everycook/EveryCook-PCB-layouts/README.md

EveryCook-PCB-layouts
=====================

All PCB layouts for the latest EveryCook. They work together, therefore they have a common repository
