everycook/EveryCook-PCB-layouts/EveryCook_boards_spec_V2.ods

Sheet: Logic_board
Line/Signal | In/Out | Voltage (V) | Current (A) | Routed to | Routed to | Remarks | RasPI | Atmel | Schema_Check
Power 12V | Input | 12 | 1 | Voltage Regulator | ProxSwPWR+ | Feeding power | 0 | 0 | x
Power 5V | Input | 5 | 3 | Voltage Regulator | ProxSwPWR+ | Feeding power | 0 | 0 | x
Power GND | Input | 10-30 | 3 | Voltage Regulator | ProxSwPWR- | Feeding power | 0 | 0 | x
ProxSwPWR+ | Output | 10-30 | 0.1 |  |  | Motor proximity switch | 0 | 0 | x
ProxSwPWR- | Output | 10-30 | 0.1 |  |  | Motor proximity switch | 0 | 0 | x
ProxSwSig | Input | 0 | 0.01 | Atmel |  | Motor proximity switch | 0 | 1 | x
MotorPWM | Output | 3.3 | 0.01 | Atmel |  |  | 0 | 1 | x
CoverClosedSW+ | Input | 5 | 0.01 | RasPi GPIO |  | Safety | 1 | 0 | x
coverClosedSW- | Output | 0 | 0.01 | GND |  |  | 0 | 0 | x
CoverLockedSW+ | Input | 5 | 0.01 | RasPi GPIO |  | Safety | 1 | 0 | x
CoverLockedSW- | Output | 0 | 0.01 | GND |  |  | 0 | 0 | x
PusherLockedSW+ | Input | 5 | 0.01 | RasPi GPIO |  | Safety | 1 | 0 | x
PusherLockedSW- | Output | 0 | 0.01 | GND |  |  | 0 | 0 | x
Button1+ | Input | 5 | 0.01 | RasPi GPIO |  | WIFI/DaemonRST, Shutdown | 1 | 0 | x
Button1- | Output | 0 | 0.01 | GND |  |  | 0 | 0 | x
Button2+ | Input | 5 | 0.01 | RasPi GPIO |  | Read step/ON/OFF | 1 | 0 | x
Button2- | Output | 0 | 0.01 | GND |  |  | 0 | 0 | x
Button3+ | Input | 5 | 0.01 | RasPi GPIO |  | Next step | 1 | 0 | x
Button3- | Output | 0 | 0.01 | GND |  |  | 0 | 0 | x
Loadcell1P+ | Output | 5 | 0.01 | precise 5V |  |  | 0 | 0
Loadcell1Sig+ | Input | 0.1 | 0.01 | AD7794 |  |  | 0 | 0
Loadcell1Sig- | Input | 0.1 | 0.01 | AD7794 |  |  | 0 | 0
Loadcell1P- | Output | 0 | 0.01 | GND |  |  | 0 | 0
Loadcell2P+ | Output | 5 | 0.01 | precise 5V |  |  | 0 | 0
Loadcell2Sig+ | Input | 0.1 | 0.01 | AD7794 |  |  | 0 | 0
Loadcell2Sig- | Input | 0.1 | 0.01 | AD7794 |  |  | 0 | 0
Loadcell2P- | Output | 0 | 0.01 | GND |  |  | 0 | 0
Loadcell3P+ | Output | 5 | 0.01 | precise 5V |  |  | 0 | 0
Loadcell3Sig+ | Input | 0.1 | 0.01 | AD7794 |  |  | 0 | 0
Loadcell3Sig- | Input | 0.1 | 0.01 | AD7794 |  |  | 0 | 0
Loadcell3P- | Output | 0 | 0.01 | GND |  |  | 0 | 0
Loadcell4P+ | Output | 5 | 0.01 | precise 5V |  |  | 0 | 0
Loadcell4Sig+ | Input | 0.1 | 0.01 | AD7794 |  |  | 0 | 0
Loadcell4Sig- | Input | 0.1 | 0.01 | AD7794 |  |  | 0 | 0
Loadcell4P- | Output | 0 | 0.01 | GND |  |  | 0 | 0
PressuresensorP+ | Output | 5 | 0.01 | precise 5V |  |  | 0 | 0
PressuresensorSig+ | Input | 0.1 | 0.01 | AD7794 |  |  | 0 | 0
PressuresensorSig- | Input | 0.1 | 0.01 | AD7794 |  |  | 0 | 0
PressuresensorP- | Output | 0 | 0.01 | GND |  |  | 0 | 0
PT100+ | Input | 5 | 0.01 | AD7794 |  |  | 0 | 0
PT100- | Output | 0 | 0.01 | GND |  |  | 0 | 0
IH_ON | Output | 3.3 | 0.01 | RasPi GPIO |  |  | 1 | 0 | x
IH OFF | Output | 3.3 | 0.01 | RasPi GPIO |  |  | 1 | 0 | x
IH_POWER | Output | 3.3 | 0.01 | RasPi GPIO |  |  | 1 | 0 | x
IH_FEEDBACK | Input | 3.3 | 0.01 | RasPi GPIO |  |  | 1 | 0 | x
Powerbutton_LED+ | Output | 3.3 | 0.01 | RasPi GPIO |  |  | 1 | 0
Powerbutton_LED- | Output | 0 | 0.01 | GND |  |  | 0 | 0
Speaker+ | Output |  |  | AudioAmp |  |  | 0 | 0
Speaker- | Output | 0 |  | AudioAmp |  |  | 0 | 0
AudioIn+ | Input |  |  | AudioAmp |  |  | 0 | 0
AudioIn- | Output | 0 |  | AudioAmp |  |  | 0 | 0
Rpi_TX | Output | 3.3 | 0.01 | RasPi GPIO |  |  | 1 | 0 | x
Rpi_RX | Input | 3.3 | 0.01 | RasPi GPIO |  |  | 1 | 0 | x
Atmel_RST_OUT | Output | 3.3 | 0.01 | RasPi GPIO |  |  | 1 | 0 | x
Atmel_Rx | Input | 3.3 | 0.01 | Atmel |  |  | 0 | 1 | x
Atmel_Tx | Output | 3.3 | 0.01 | Atmel |  |  | 0 | 1 | x
Atmel_RST_IN | Input | 3.3 | 0.01 | Atmel |  |  | 0 | 1 | x
SPI_CLK | Output | 3.3 | 0.01 | RasPi GPIO |  |  | 1 | 0 | x
SPI_MISO | Input | 3.3 | 0.01 | RasPi GPIO |  |  | 1 | 0 | x
SPI_MOSI | Output | 3.3 | 0.01 | RasPi GPIO |  |  | 1 | 0 | x
Display 1 | Output | 3.3 | 0.01 | Atmel |  |  | 0 | 1 | x
Display 2 | Output | 3.3 | 0.01 | Atmel |  |  | 0 | 1 | x
Display 3 | Output | 3.3 | 0.01 | Atmel |  |  | 0 | 1 | x
Display 4 | Output | 3.3 | 0.01 | Atmel |  |  | 0 | 1 | x
Display 5 | Output | 3.3 | 0.01 | Atmel |  |  | 0 | 1 | x
Display 6 | Output | 3.3 | 0.01 | Atmel |  |  | 0 | 1 | x
Display 7 | Output | 3.3 | 0.01 | Atmel |  |  | 0 | 1 | x
Display 8 | Output | 3.3 | 0.01 | Atmel |  |  | 0 | 1 | x
Display 9 | Output | 3.3 | 0.01 | Atmel |  |  | 0 | 1 | x
Display 10 | Output | 3.3 | 0.01 | Atmel |  |  | 0 | 1 | x
Display 11 | Output | 3.3 | 0.01 | Atmel |  |  | 0 | 1 | x
Display 12 | Output | 3.3 | 0.01 | Atmel |  |  | 0 | 1 | x
RasPi Reset | Output | 3.3 | 0.01 | Atmel |  |  | 0 | 1 | x
FanPWM | Output | 3.3 | 0.01 | Atmel |  |  | 0 | 1 | x
IGBT_Temp | Input | 3.3 | 0.01 | Atmel |  |  | 0 | 1 | x
HiPower_ON | Output | 3.3 | 0.01 | Atmel |  |  | 0 | 1 | x
 |  |  |  |  |  | Sum | 17 | 21
 |  |  |  |  |  | Reserves | 1 | 0
Raspi GPIOs | 18 | Total | Arduino IO's | 21 | Inkl. RST
Reserve | 0 |  | Reserve | 0
Available | 18 |  | Available | 21

Sheet: Power_board
Line/Signal | In/Out | Voltage (V) | Current (A) | AC/DC | Routed to | Routed to | Remarks
PWR_GND | Input | 0 | 0 | DC | Housing via mounting holes | Connector for other GNDs | General Shielding for EMI and safety
PWR_N_on | Input | 0 | 16 | AC | Rectifier 1A | Rectifier 16A | For 10-30V IH logic and signal board power
PWR_L_on | Input | 230 | 16 | AC | Rectifier 1A | PWR_L_OUT | For 10-30V IH logic and signal board power
PWR_L_OUT | Output | 230 | 16 | AC | Connector to switch |  | To emergency shutdown/Power Switch
PWR_L_sw | Input | 230 | 16 | AC | Rectifier 16A |  | From emergency shutdown/Power Switch
IH_ON | Input | 5 | 0.01 | DC | Optocoupler |  | From signal board, enables heater
IH_POWER | Input | 5 | 0.01 | DC | Optocoupler |  | From signal board, sets heating power in 25% steps
IH_FEEDBACK | Output | 0 | 0.01 | DC | Optocoupler |  | To signal board, tells heating power
IH_COIL+ | Output | 1200 | 50 | AC | IH Circuit |  | TBD
IH_COIL- | Output | 1200 | 50 | AC | iH Circuit |  | TBD
Motor+ | Output | 325 | 2 | DC | DC BUS - |  | Motor GND
Motor- | Output | 325 | 2 | DC | IGBT |  | Motor PWM
DC_OUT | Output | 10-30 | 3 | DC | Voltage Converter |  | Voltage TBD for Logic Board
DC_OUT | Output | 10-30 | 3 | DC | Voltage Converter |  | Voltage TBD for Logic Board
Motor PWM | Input | 5 | 0.01 | DC | IGBT |  | PWM Signal from Logic board
PowerButton1+ | Input | 230 | 0.1 | AC | PowerOnCircuit
Powerbutton1- | Input | 0 | 0.1 | AC | PowerOnCircuit
PowerButton2+ | Input | 230 | 0.1 | AC | PowerOnCircuit
Powerbutton2- | Input | 0 | 0.1 | AC | PowerOnCircuit

Sheet: notes
OK Spule zu UK Topf | 17 | mm
