everycook/EveryCook-PCB-layouts/Datasheets/FNA41060B2-schema.jpeg

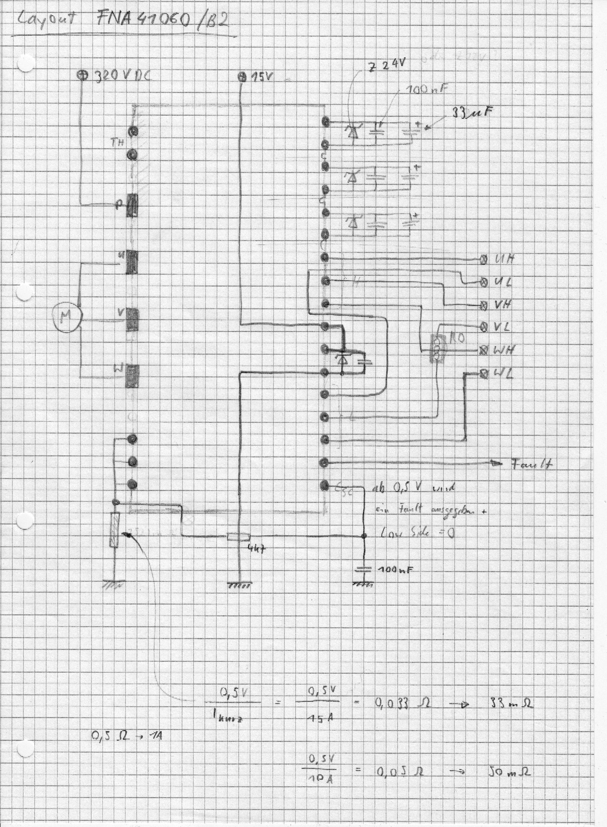
Datasheets/FNA41060B2-schema.jpeg
