everycook/EveryCook-PCB-layouts/Datasheets/MC3PHAC-schema.jpeg

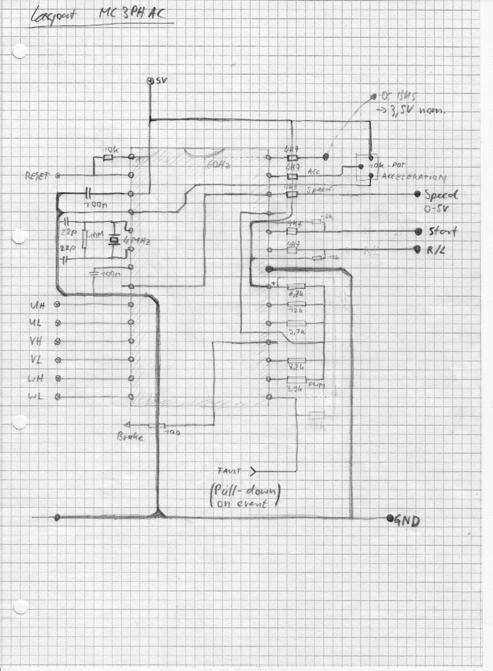
Datasheets/MC3PHAC-schema.jpeg
