everycook/EveryCook-PCB-layouts/Examples/arduino-duemilanove-sch.gif

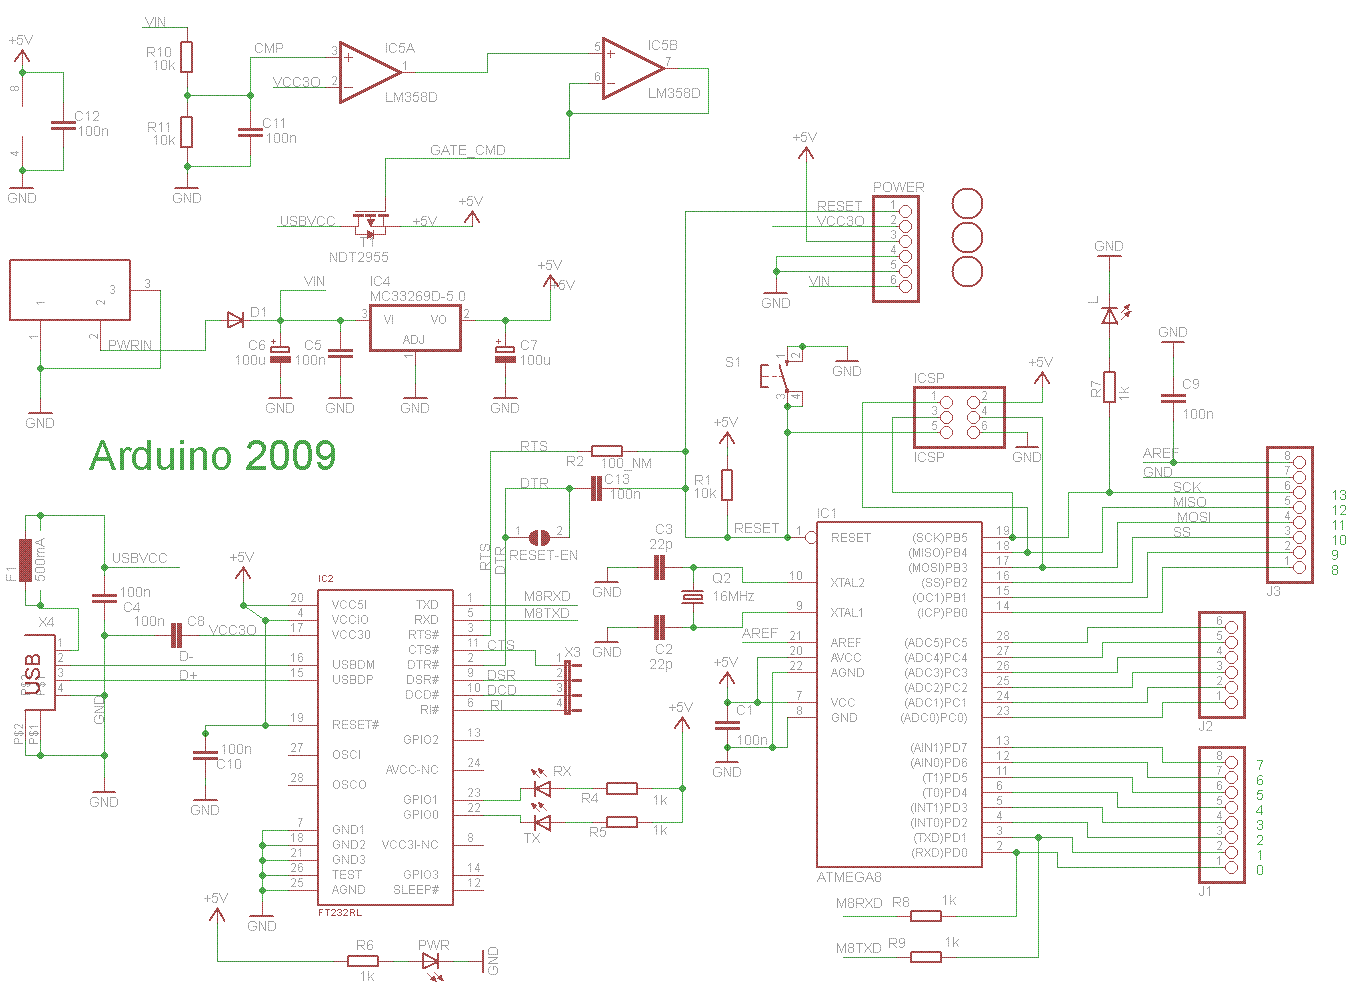
Examples/arduino-duemilanove-sch.gif
