everycook/EveryCook-PCB-layouts/Examples/Sanguino.png

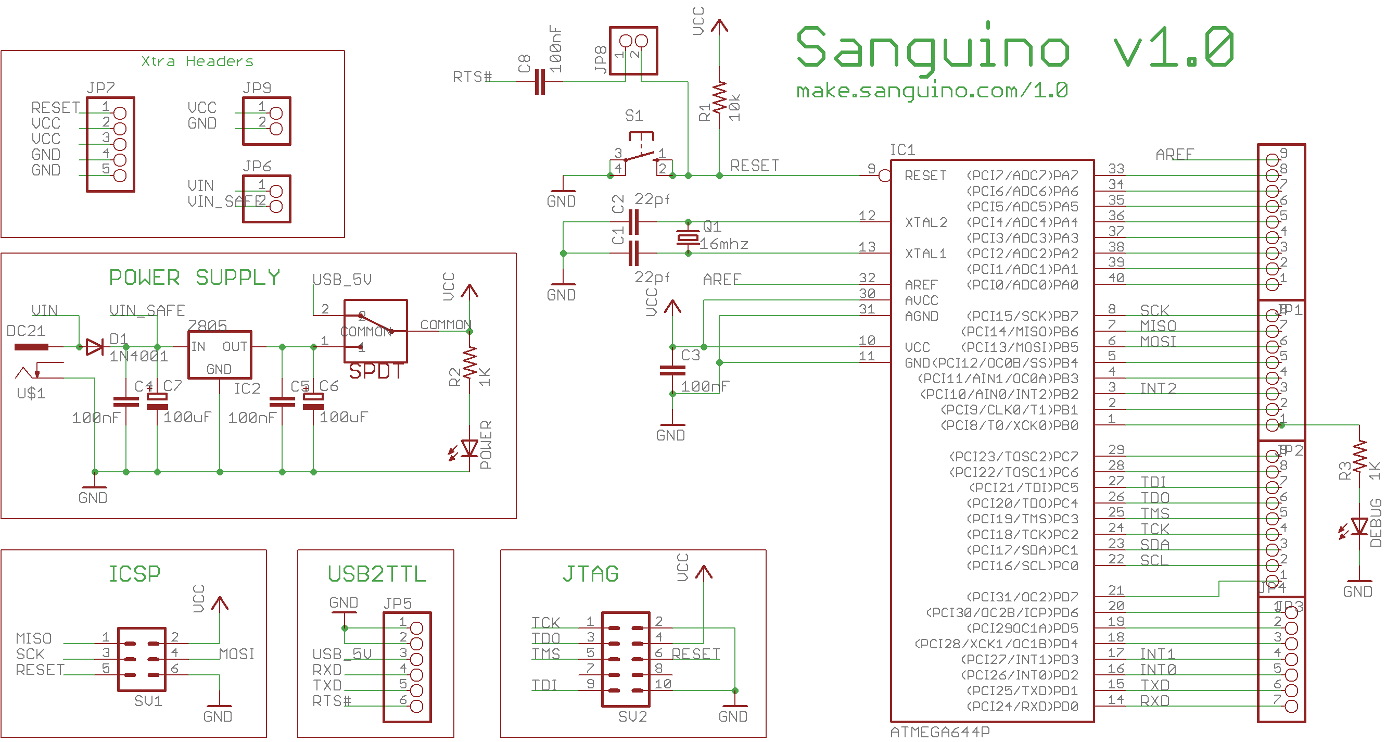
Examples/Sanguino.png
