everycook/EveryCook-PCB-layouts/LoadCellAmp/LoadCellAmp.png

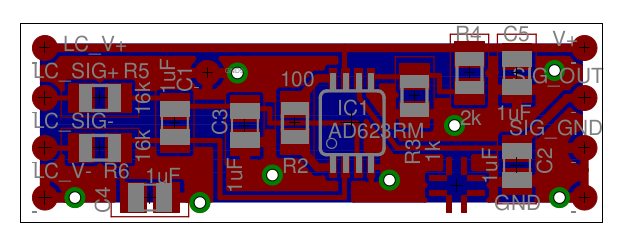
LoadCellAmp/LoadCellAmp.png
