everycook/EveryCook-PCB-layouts/Display/Display_EveryCook.xls

Part | Value | Device | Package | Description | Color
JP1 |  | PINHD-2X6 | 2X06 | PIN HEADER
LED1 |  | LEDKA-3528ASYC | KA-3528ASYC | LED | blue
LED2 |  | LEDKA-3528ASYC | KA-3528ASYC | LED | blue
LED3 |  | LEDKA-3528ASYC | KA-3528ASYC | LED | blue
LED4 |  | LEDKA-3528ASYC | KA-3528ASYC | LED | blue
LED5 |  | LEDKA-3528ASYC | KA-3528ASYC | LED | blue
LED6 |  | LEDKA-3528ASYC | KA-3528ASYC | LED | blue
LED7 |  | LEDKA-3528ASYC | KA-3528ASYC | LED | blue
LED8 |  | LEDKA-3528ASYC | KA-3528ASYC | LED | blue
LED9 |  | LEDKA-3528ASYC | KA-3528ASYC | LED | blue
LED10 |  | LEDKA-3528ASYC | KA-3528ASYC | LED | blue
LED11 |  | LEDKA-3528ASYC | KA-3528ASYC | LED | blue
LED12 |  | LEDKA-3528ASYC | KA-3528ASYC | LED | blue
LED13 |  | LEDKA-3528ASYC | KA-3528ASYC | LED | blue
LED14 |  | LEDKA-3528ASYC | KA-3528ASYC | LED | blue
LED15 |  | LEDKA-3528ASYC | KA-3528ASYC | LED | blue
LED16 |  | LEDKA-3528ASYC | KA-3528ASYC | LED | blue
LED17 |  | LEDKA-3528ASYC | KA-3528ASYC | LED | blue
LED18 |  | LEDKA-3528ASYC | KA-3528ASYC | LED | blue
LED19 |  | LEDKA-3528ASYC | KA-3528ASYC | LED | blue
LED20 |  | LEDKA-3528ASYC | KA-3528ASYC | LED | blue
LED21 |  | LEDKA-3528ASYC | KA-3528ASYC | LED | blue
LED22 |  | LEDKA-3528ASYC | KA-3528ASYC | LED | blue
LED23 |  | LEDKA-3528ASYC | KA-3528ASYC | LED | blue
LED24 |  | LEDKA-3528ASYC | KA-3528ASYC | LED | blue
LED25 |  | LEDKA-3528ASYC | KA-3528ASYC | LED | blue
LED26 |  | LEDKA-3528ASYC | KA-3528ASYC | LED | blue
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
LED107 |  | LEDKA-3528ASYC | KA-3528ASYC | LED | blue
LED108 |  | LEDKA-3528ASYC | KA-3528ASYC | LED | blue
LED109 |  | LEDKA-3528ASYC | KA-3528ASYC | LED | blue
LED110 |  | LEDKA-3528ASYC | KA-3528ASYC | LED | blue
LED111 |  | LEDKA-3528ASYC | KA-3528ASYC | LED | blue
LED112 |  | LEDKA-3528ASYC | KA-3528ASYC | LED | blue
LED113 |  | LEDKA-3528ASYC | KA-3528ASYC | LED | blue
LED114 |  | LEDKA-3528ASYC | KA-3528ASYC | LED | blue
LED115 |  | LEDKA-3528ASYC | KA-3528ASYC | LED | blue
LED116 |  | LEDKA-3528ASYC | KA-3528ASYC | LED | blue
LED117 |  | LEDKA-3528ASYC | KA-3528ASYC | LED | blue
LED118 |  | LEDKA-3528ASYC | KA-3528ASYC | LED | blue
LED119 |  | LEDKA-3528ASYC | KA-3528ASYC | LED | blue
LED120 |  | LEDKA-3528ASYC | KA-3528ASYC | LED | blue
LED121 |  | LEDKA-3528ASYC | KA-3528ASYC | LED | blue
LED122 |  | LEDKA-3528ASYC | KA-3528ASYC | LED | blue
LED123 |  | LEDKA-3528ASYC | KA-3528ASYC | LED | blue
LED124 |  | LEDKA-3528ASYC | KA-3528ASYC | LED | blue
LED125 |  | LEDKA-3528ASYC | KA-3528ASYC | LED | blue
LED126 |  | LEDKA-3528ASYC | KA-3528ASYC | LED | blue
