everycook/EveryCook-PCB-layouts/IH/EveryCookPWR (Alexis Wiasmitinows in Konflikt stehende Kopie 2014-01-17).dxf

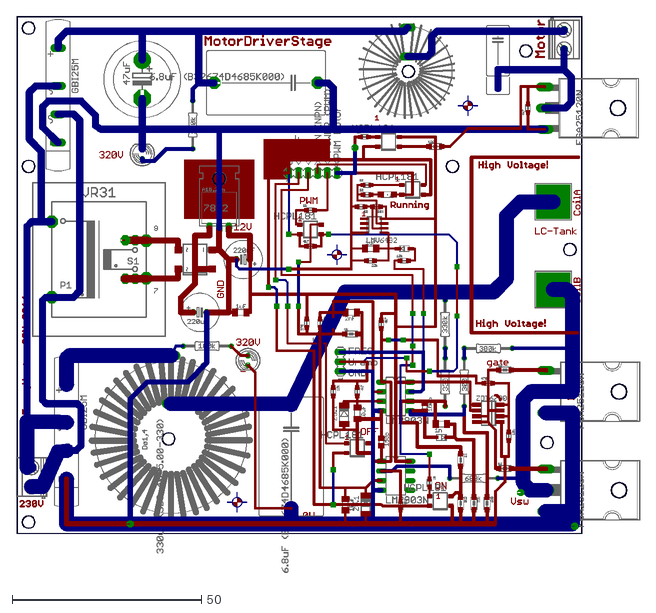
[picture p6: CAD file, 2014-01-18]
IH/EveryCookPWR (Alexis Wiasmitinows in Konflikt stehende Kopie 2014-01-17).dxf
164.9 x 147.0
