everycook/EveryCook-PCB-layouts/LoadCellAmp/LoadCellAmp.dxf

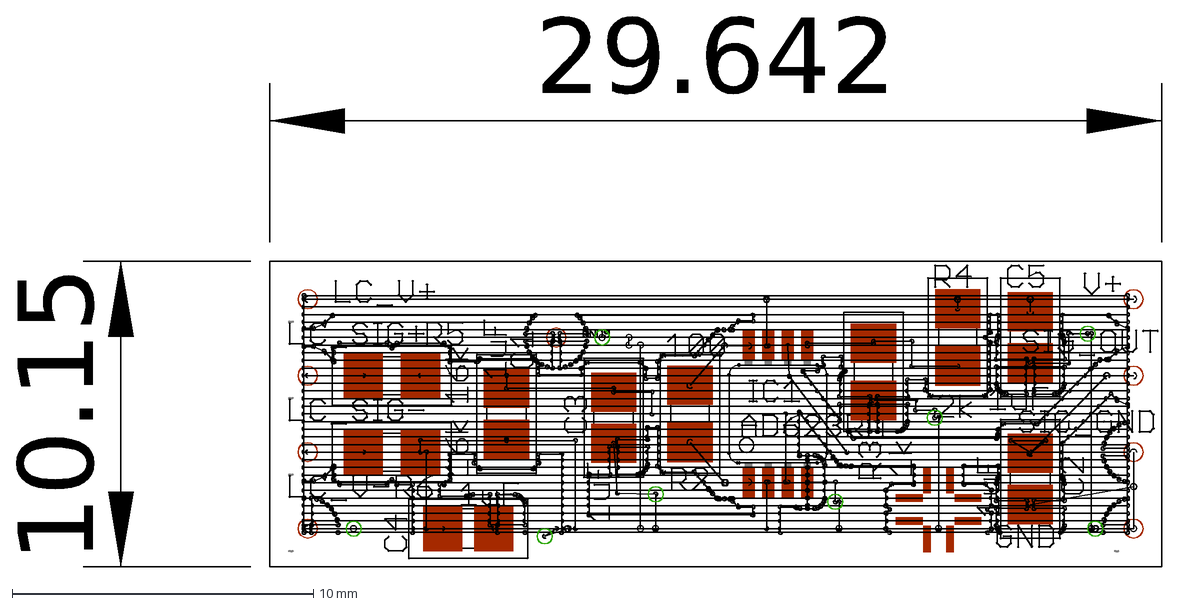
[picture p7: CAD file, 2014-08-21]
LoadCellAmp/LoadCellAmp.dxf
10.15
29.642
