everycook/EveryCook-PCB-layouts/SafetyChain/SafetyChain.dxf

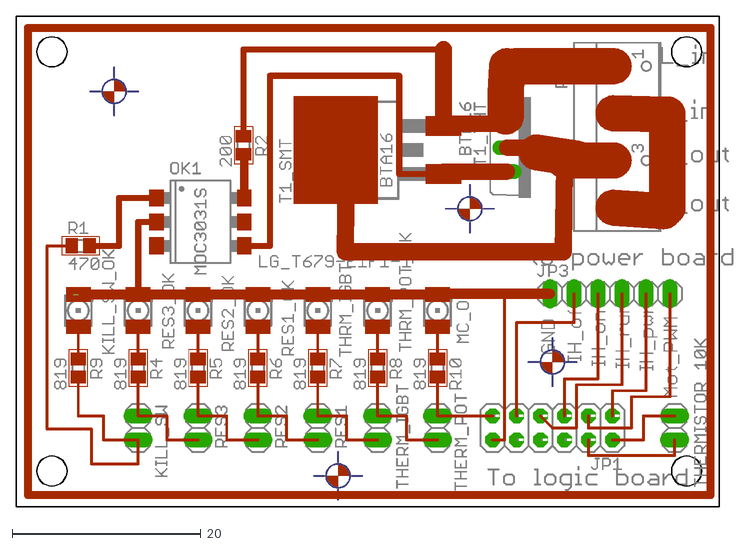
[picture p8: CAD file, 2014-02-05]
SafetyChain/SafetyChain.dxf
76.0 x 52.1
