everycook/EveryCook-PCB-layouts/IH/EveryCookPWR.dxf

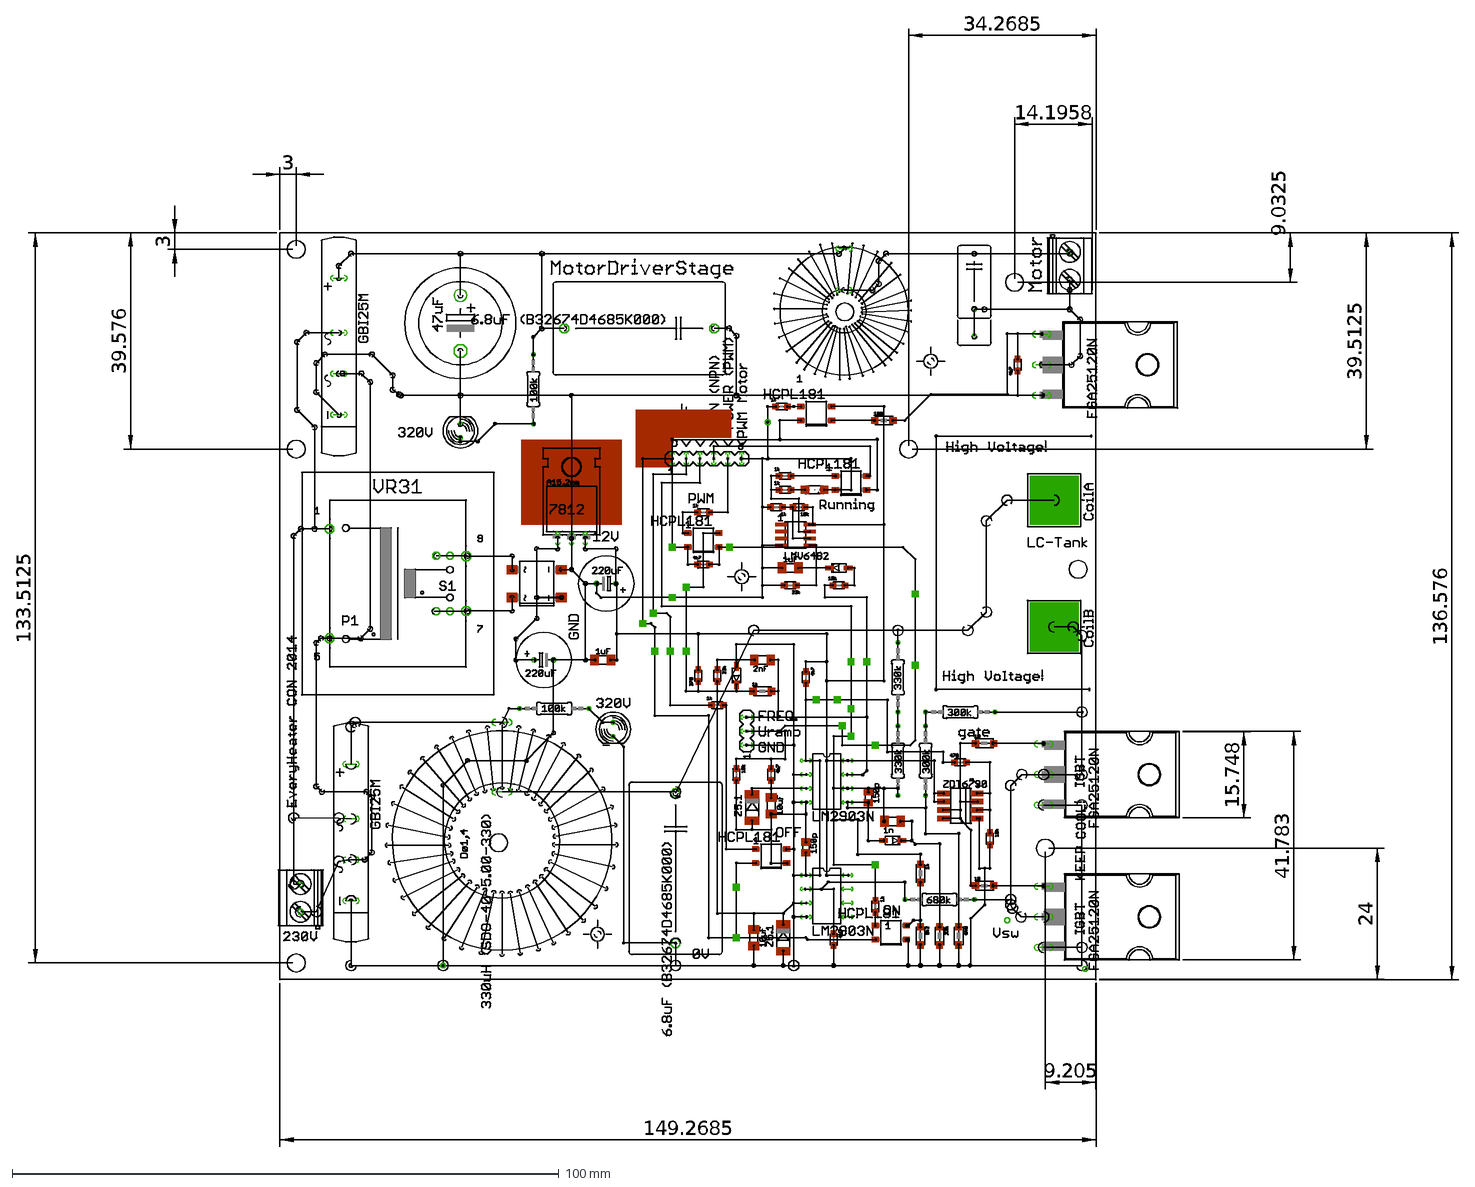
[picture p9: CAD file, 2014-01-18]
IH/EveryCookPWR.dxf
41.783
15.748
149.2685
136.576
3
39.576
133.5125
39.5125
9.0325
24
14.1958
34.2685
9.205
