everycook/EveryCook-PCB-layouts/LoadCellAmp/LoadCellAmp_brd.pdf

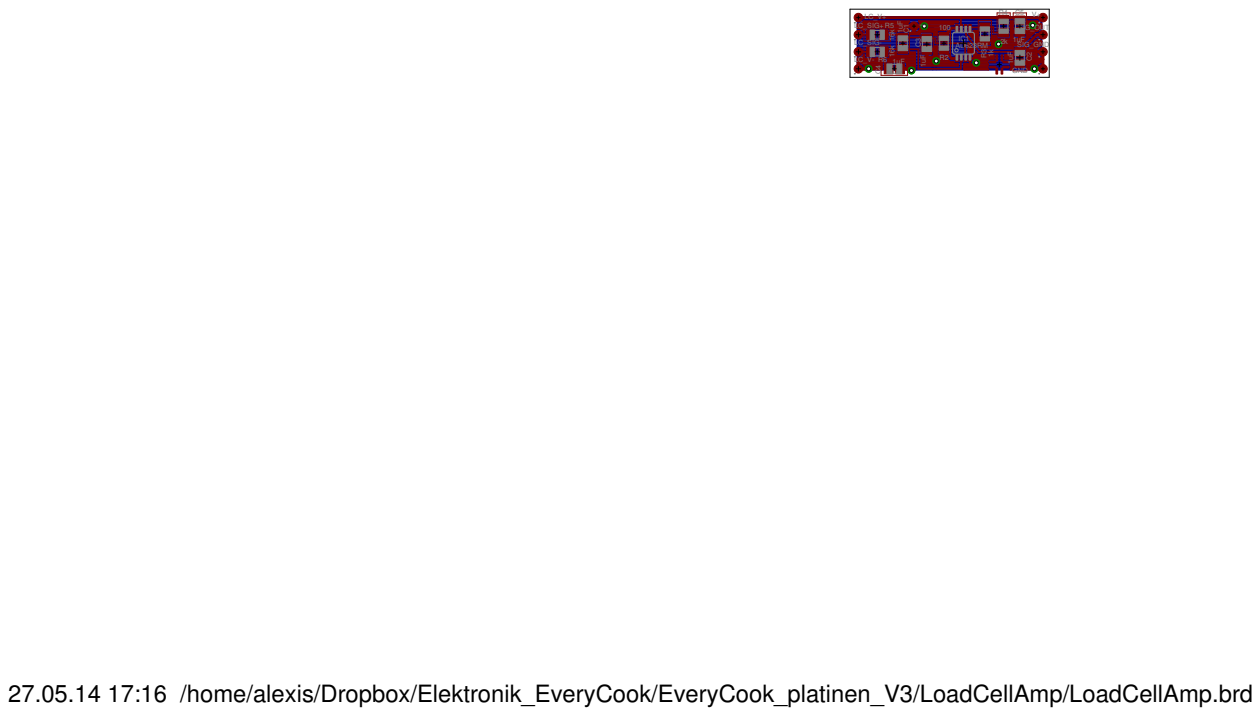
[picture p10: page 1]

LC_SIG+ 100

GND9 | R2 | AD623RM IC1 C1 | 1uF

LC_SIG- LC_V- | | | | SIG_GND

27.05.14 17:16 /home/alexis/Dropbox/Elektronik_EveryCook/EveryCook_platinen_V3/LoadCellAmp/LoadCellAmp.brd
