everycook/EveryCook-PCB-layouts/Mainboard/EveryCook_Mainboard_brd.pdf

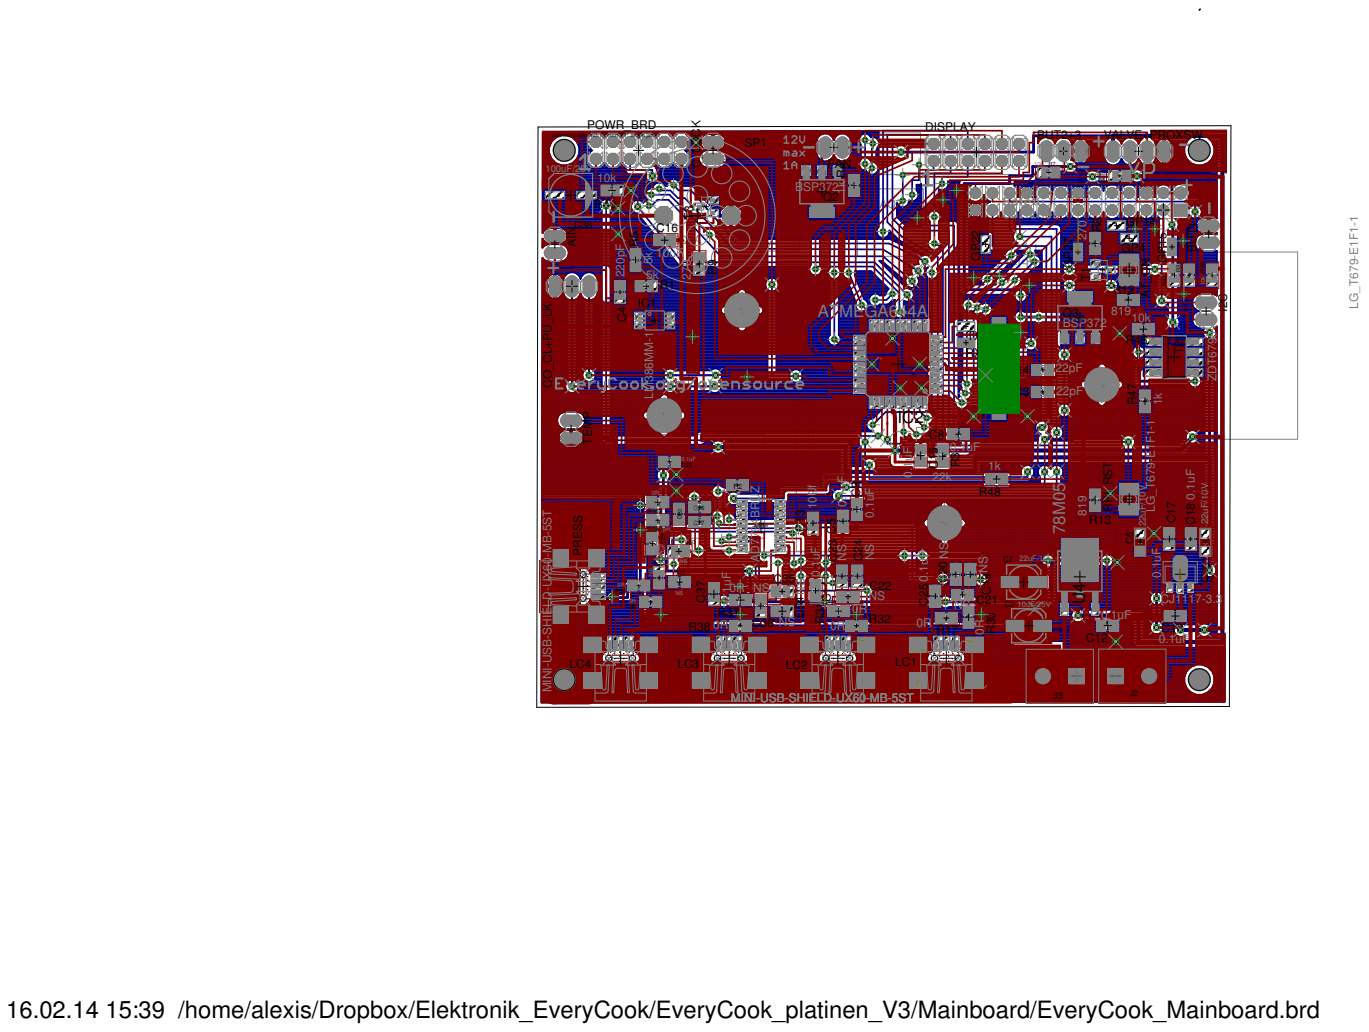
[picture p11: page 1]

connect cable with 3.5mm 90° angle jack

10k | | FAN Q2 R4 | R6 R7

BSP372 1k

BSP372 | | 10k

MINI-USB-SHIELD-UX60-MB-5ST

16.02.14 15:39 /home/alexis/Dropbox/Elektronik_EveryCook/EveryCook_platinen_V3/Mainboard/EveryCook_Mainboard.brd
