everycook/EveryCook-PCB-layouts/Examples/TRIAC-driver.pdf

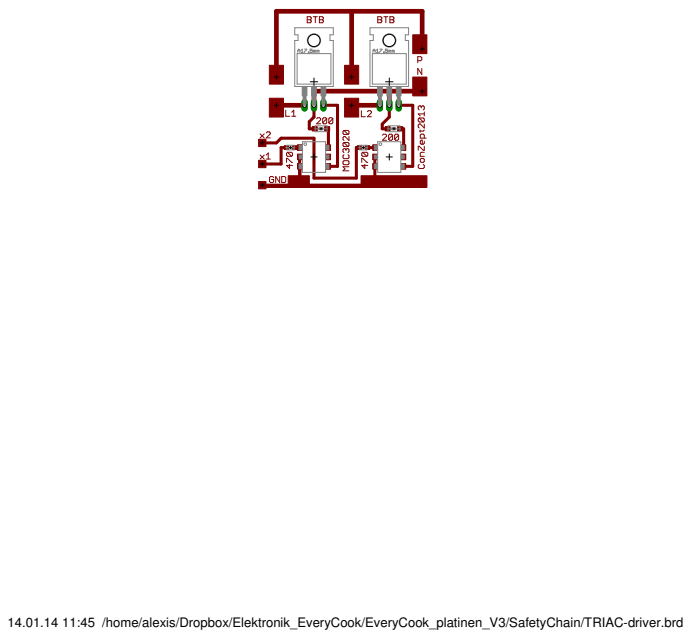
[picture p12: page 1]

14.01.14 11:45 /home/alexis/Dropbox/Elektronik_EveryCook/EveryCook_platinen_V3/SafetyChain/TRIAC-driver.brd
