everycook/EveryCook-PCB-layouts/ADC_LoadCell_Board/ADC_LoadCell_Board_brd.pdf

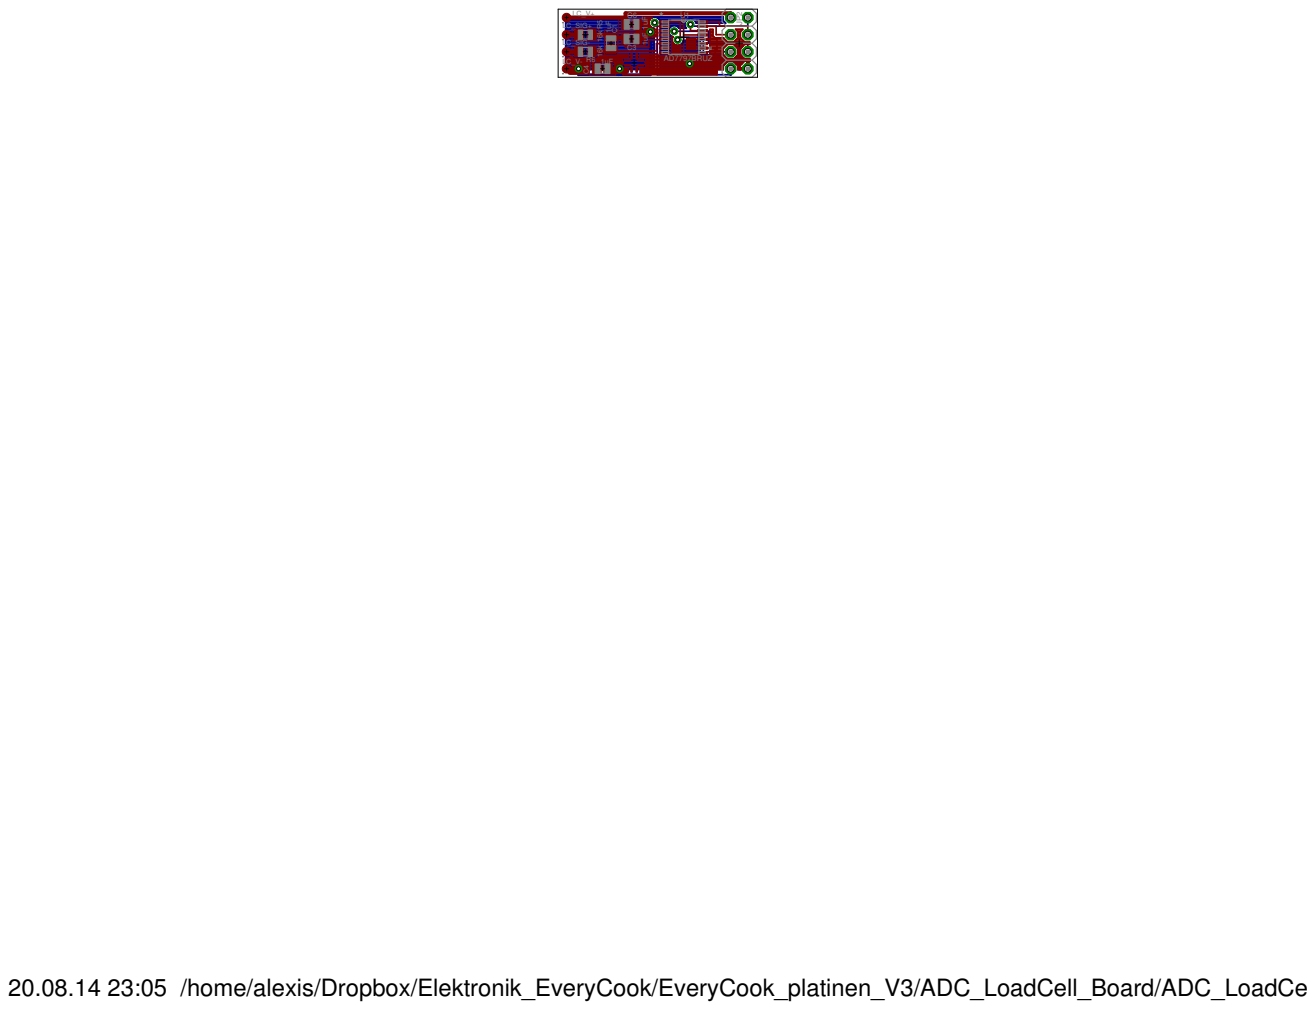
[picture p13: page 1]

20.08.14 23:05 /home/alexis/Dropbox/Elektronik_EveryCook/EveryCook_platinen_V3/ADC_LoadCell_Board/ADC_LoadCell_Board.brd
