everycook/EveryCook-PCB-layouts/ADC_LoadCell_Board/ADC_LoadCell_Board_sch.pdf

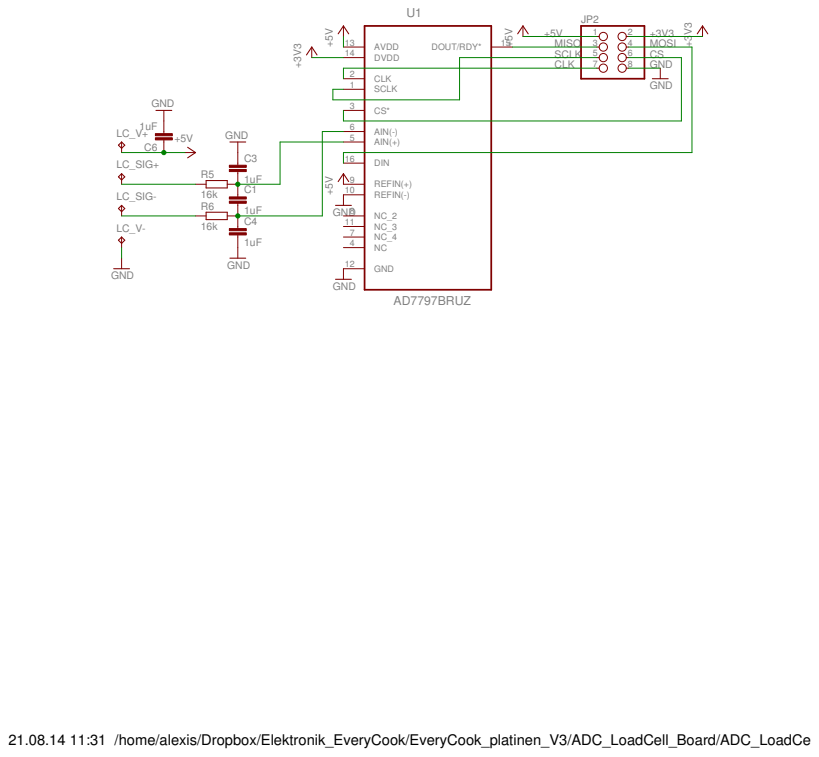
[picture p14: page 1]

21.08.14 11:31 /home/alexis/Dropbox/Elektronik_EveryCook/EveryCook_platinen_V3/ADC_LoadCell_Board/ADC_LoadCell_Board.sch (Sheet: 1/1)
