everycook/EveryCook-PCB-layouts/InductionHeater/InductionHeater.pdf

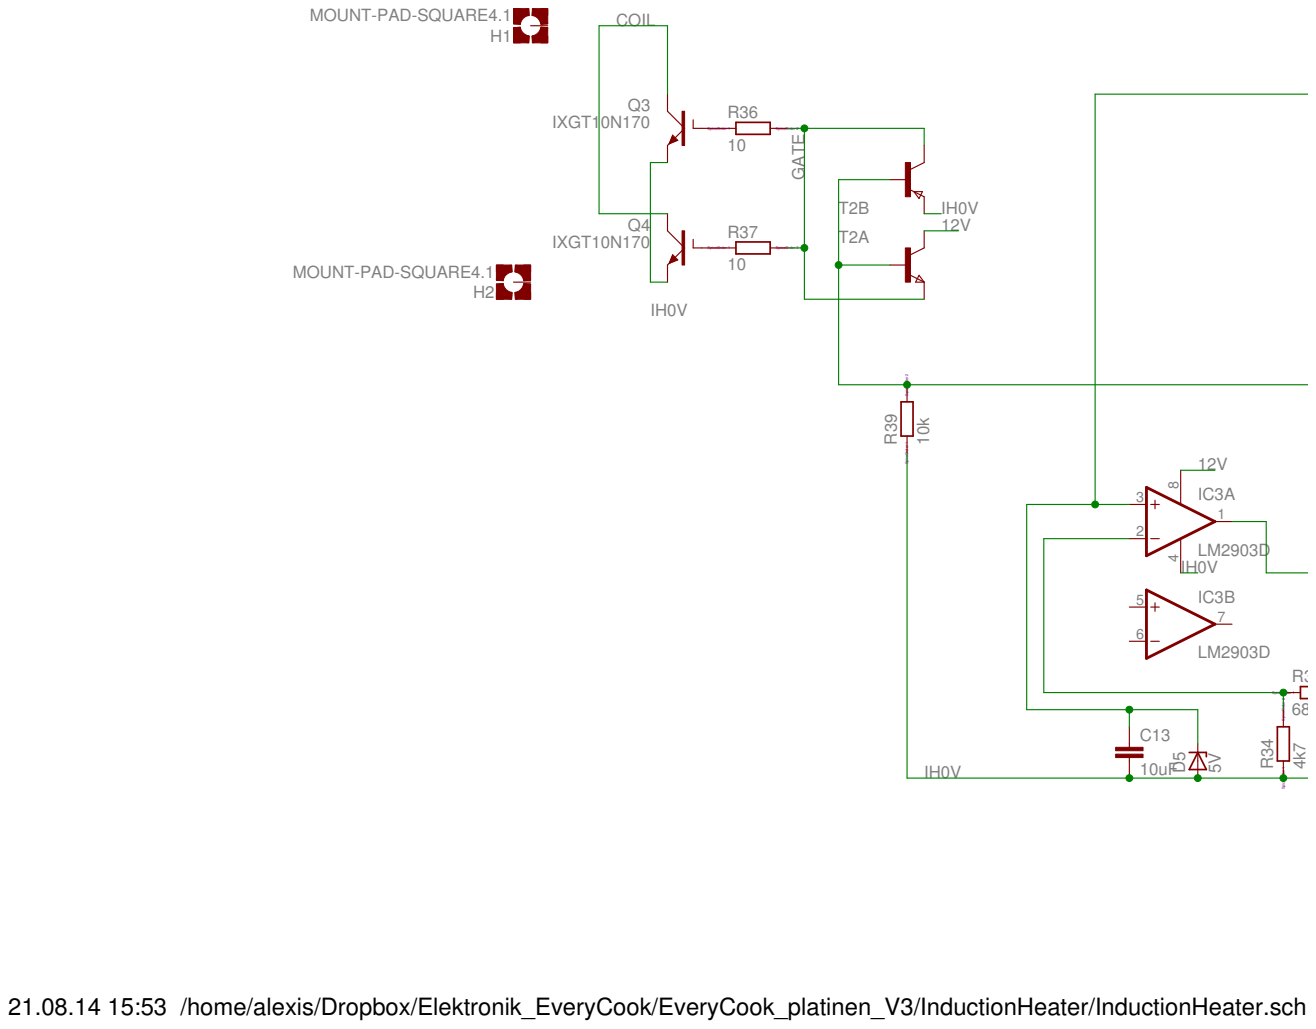
[picture p15: page 1]

21.08.14 15:53 /home/alexis/Dropbox/Elektronik_EveryCook/EveryCook_platinen_V3/InductionHeater/InductionHeater.sch (Sheet: 1/1)

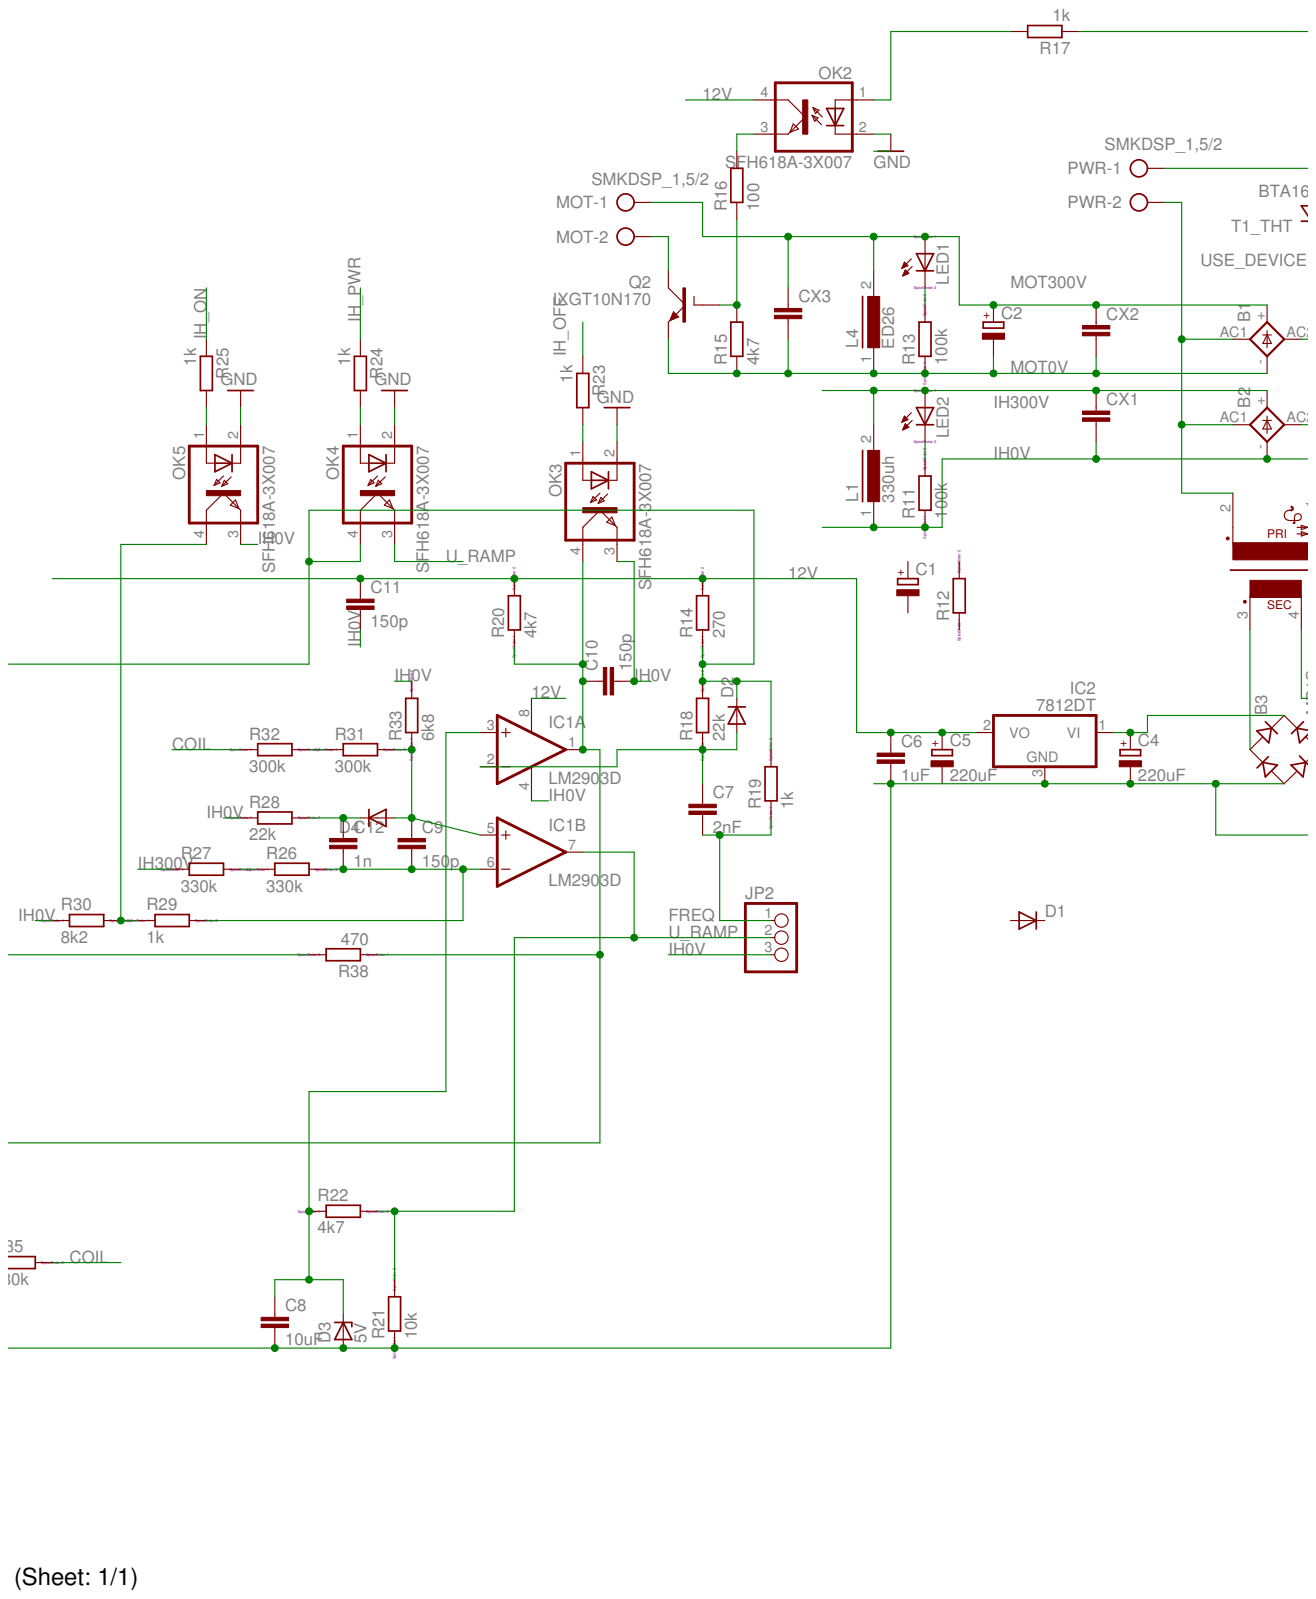
[picture p16: page 2]

SpiceOrder 1 SpiceOrder 2

21.08.14 15:53 /home/alexis/Dropbox/Elektronik_EveryCook/EveryCook_platinen_V3/InductionHeater/InductionHeater.sch (Sheet: 1/1)

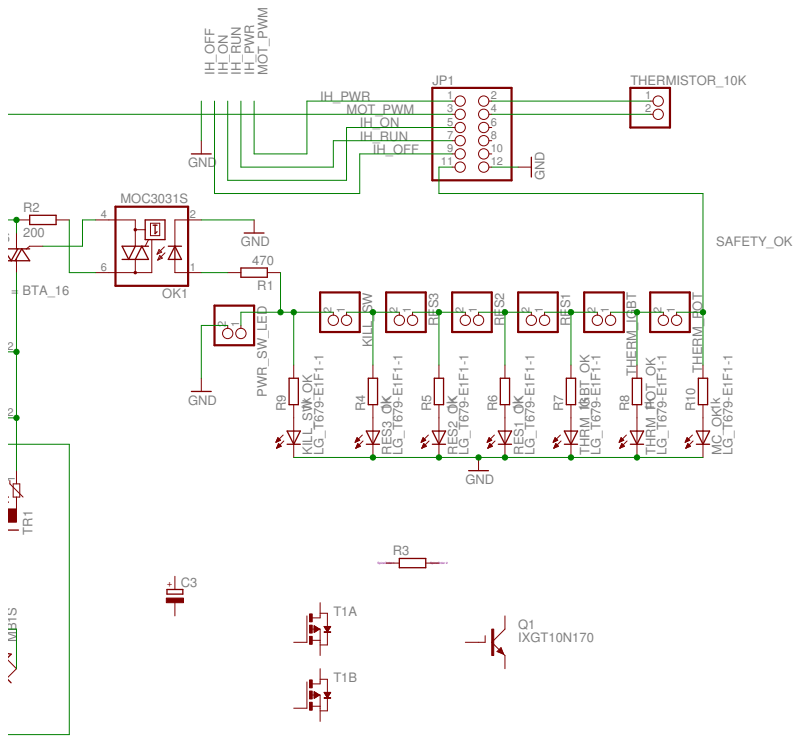
[picture p17: page 3]
