everycook/EveryCook-PCB-layouts/LoadCellAmp/LoadCellAmp_sch.pdf

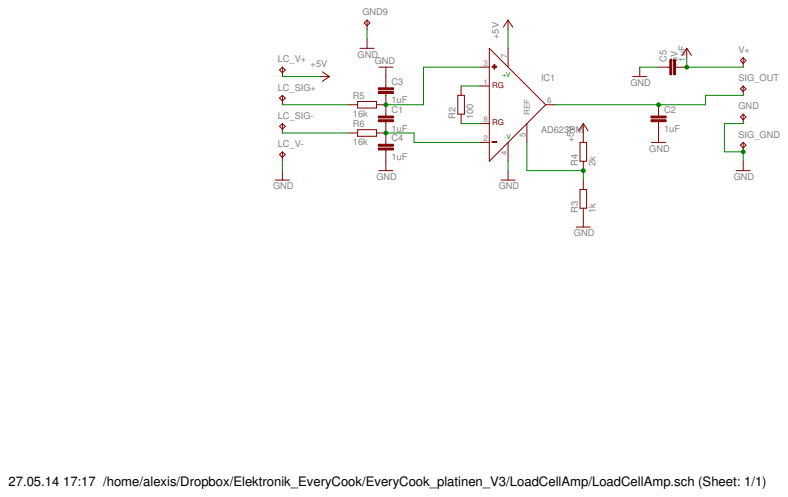
[picture p18: page 1]

27.05.14 17:17 /home/alexis/Dropbox/Elektronik_EveryCook/EveryCook_platinen_V3/LoadCellAmp/LoadCellAmp.sch (Sheet: 1/1)
