everycook/EveryCook-PCB-layouts/Mainboard/EveryCook_Mainboard_sch.pdf

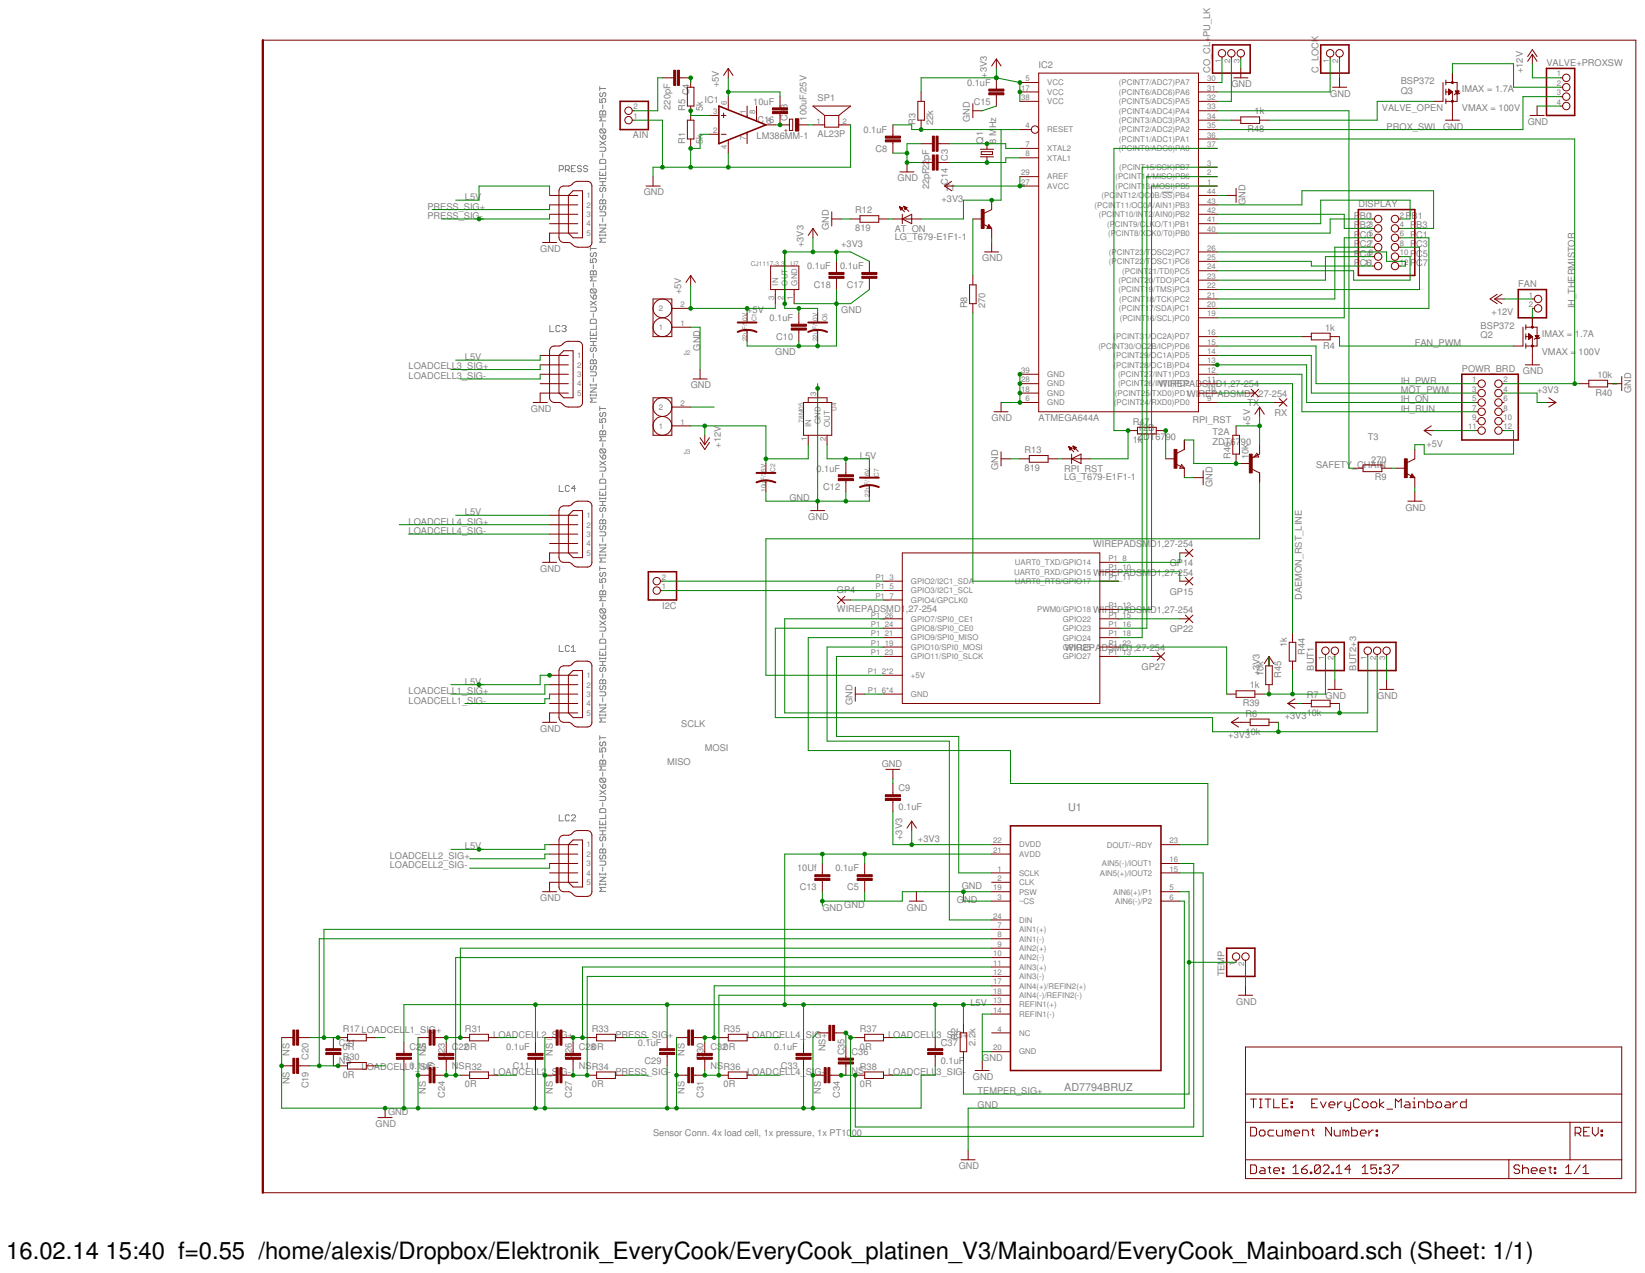
[picture p19: page 1]

16.02.14 15:40 f=0.55 /home/alexis/Dropbox/Elektronik_EveryCook/EveryCook_platinen_V3/Mainboard/EveryCook_Mainboard.sch (Sheet: 1/1)
