everycook/EveryCook-PCB-layouts/Display/Display_EveryCook_brd.pdf

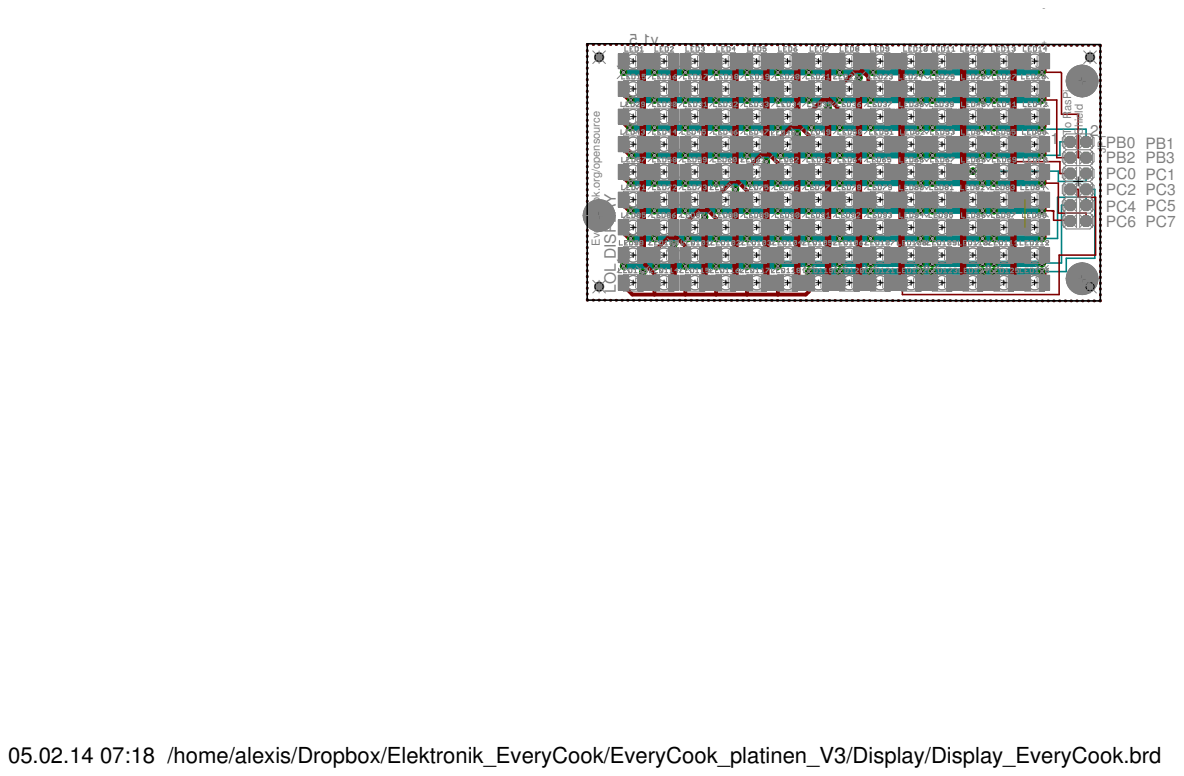
[picture p20: page 1]

EveryCook.org/opensource LOL DISPLA

05.02.14 07:18 /home/alexis/Dropbox/Elektronik_EveryCook/EveryCook_platinen_V3/Display/Display_EveryCook.brd
