everycook/EveryCook-PCB-layouts/Display/Display_EveryCook_sch.pdf

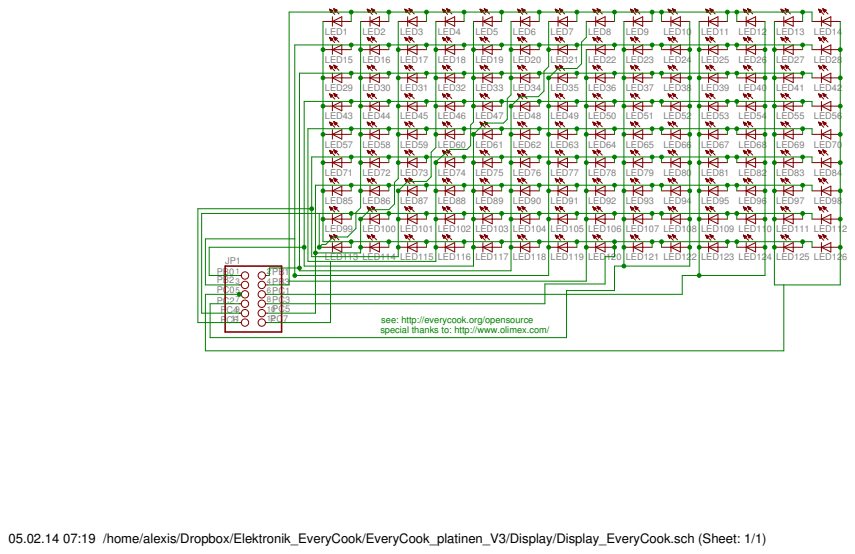
[picture p21: page 1]

special thanks to: http://www.olimex.com/ see: http://everycook.org/opensource

05.02.14 07:19 /home/alexis/Dropbox/Elektronik_EveryCook/EveryCook_platinen_V3/Display/Display_EveryCook.sch (Sheet: 1/1)
