everycook/EveryCook-PCB-layouts/Examples/SHIELD-LOL-SMT_adapted.pdf

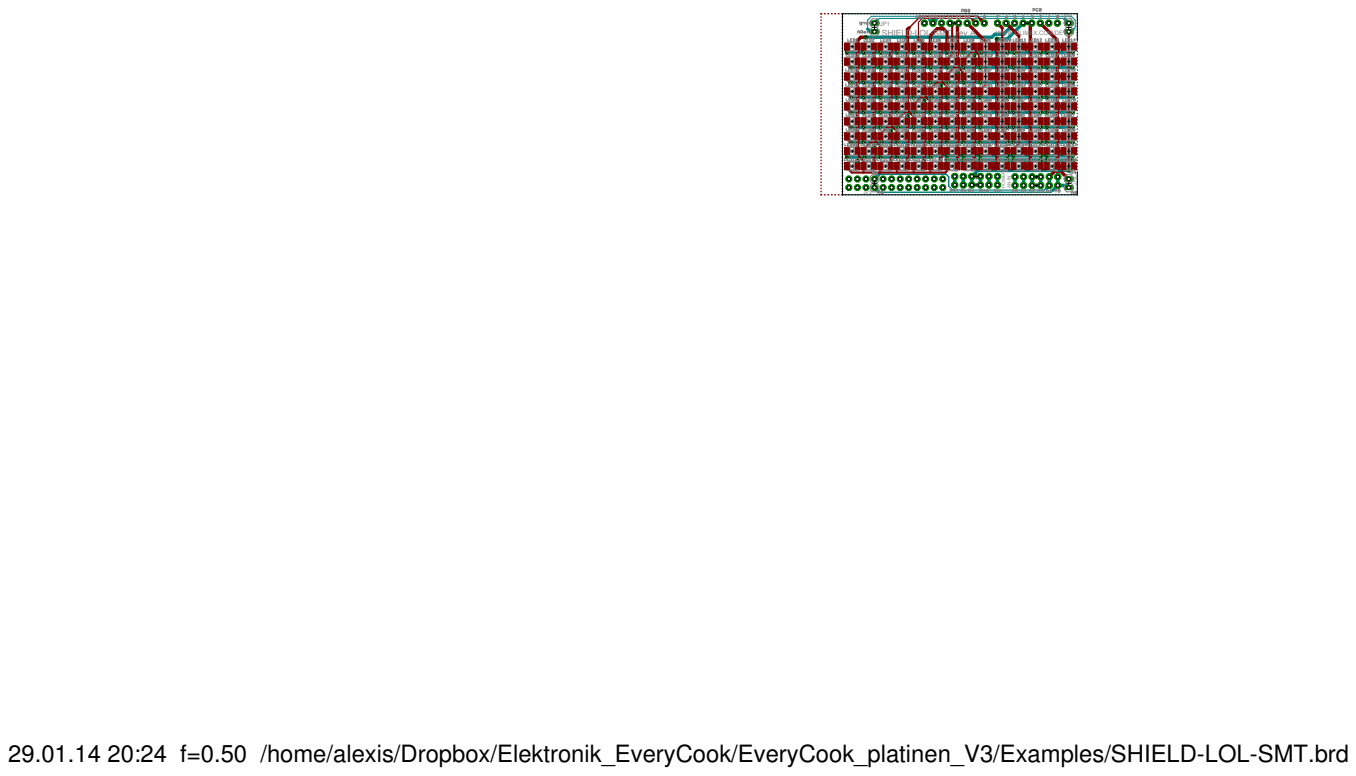
[picture p22: page 1]

29.01.14 20:24 f=0.50 /home/alexis/Dropbox/Elektronik_EveryCook/EveryCook_platinen_V3/Examples/SHIELD-LOL-SMT.brd
