everycook/EveryCook-PCB-layouts/SafetyChain/SafetyChain_brd.pdf

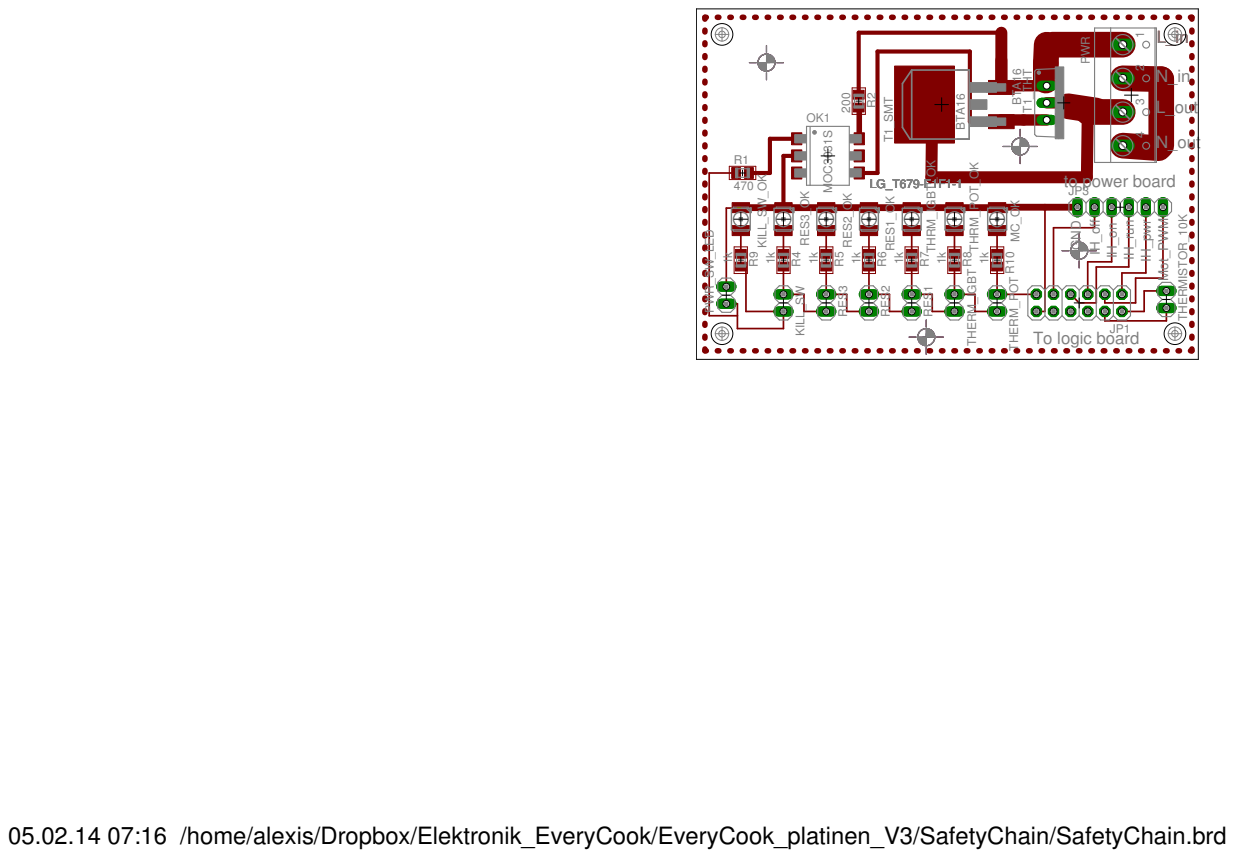
[picture p23: page 1]

05.02.14 07:16 /home/alexis/Dropbox/Elektronik_EveryCook/EveryCook_platinen_V3/SafetyChain/SafetyChain.brd
