everycook/EveryCook-PCB-layouts/SafetyChain/SafetyChain_sch.pdf

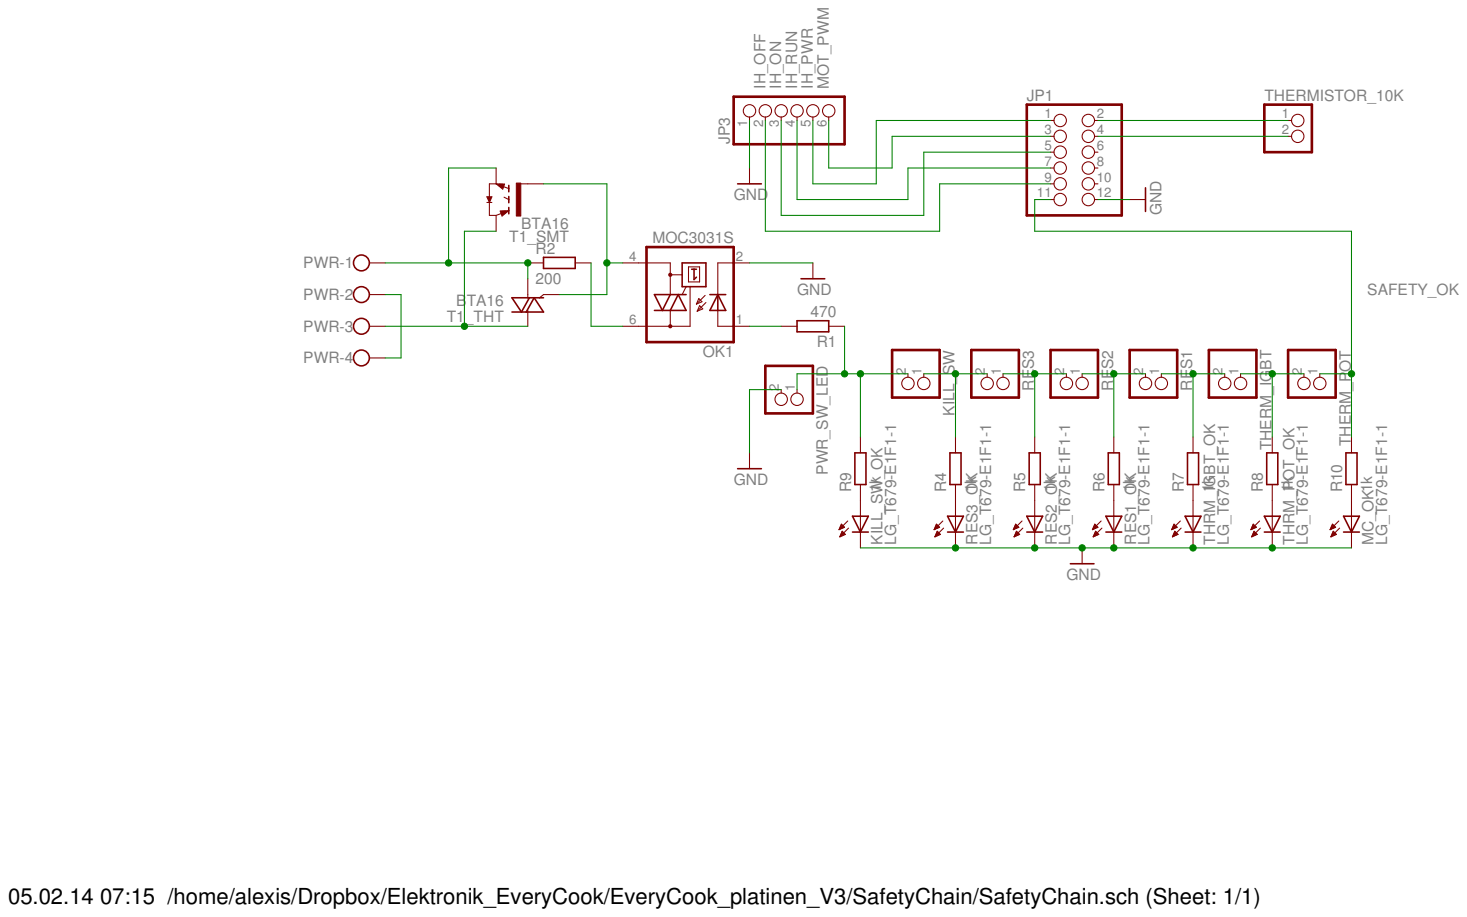
[picture p24: page 1]

05.02.14 07:15 /home/alexis/Dropbox/Elektronik_EveryCook/EveryCook_platinen_V3/SafetyChain/SafetyChain.sch (Sheet: 1/1)
