everycook/EveryCook-PCB-layouts/IH/EveryCookPWR.pdf

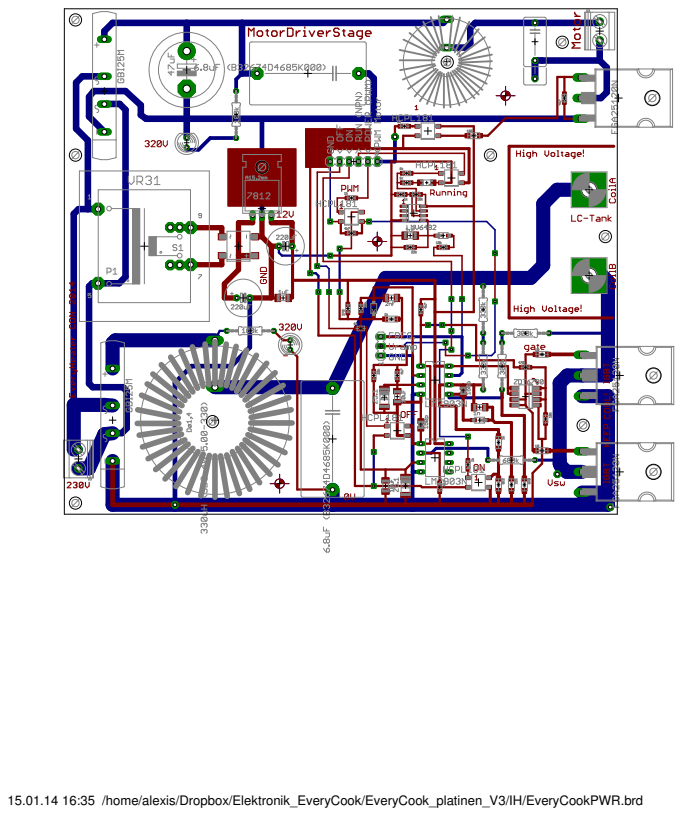
[picture p25: page 1]

15.01.14 16:35 /home/alexis/Dropbox/Elektronik_EveryCook/EveryCook_platinen_V3/IH/EveryCookPWR.brd
