everycook/EveryCook-PCB-layouts/Examples/SHIELD-LOL-SMT_Board.pdf

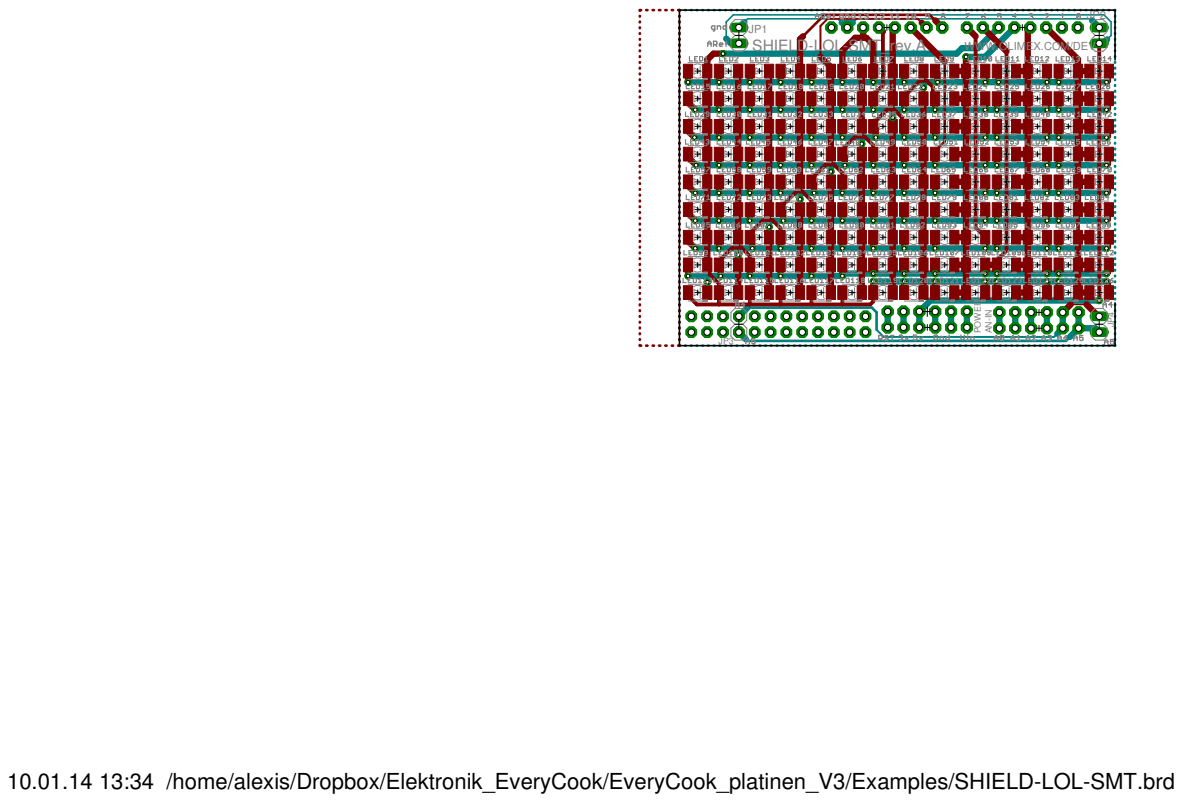
[picture p26: page 1]

10.01.14 13:34 /home/alexis/Dropbox/Elektronik_EveryCook/EveryCook_platinen_V3/Examples/SHIELD-LOL-SMT.brd
