everycook/EveryCook-PCB-layouts/Examples/SHIELD-LOL-SMT_Schema.pdf

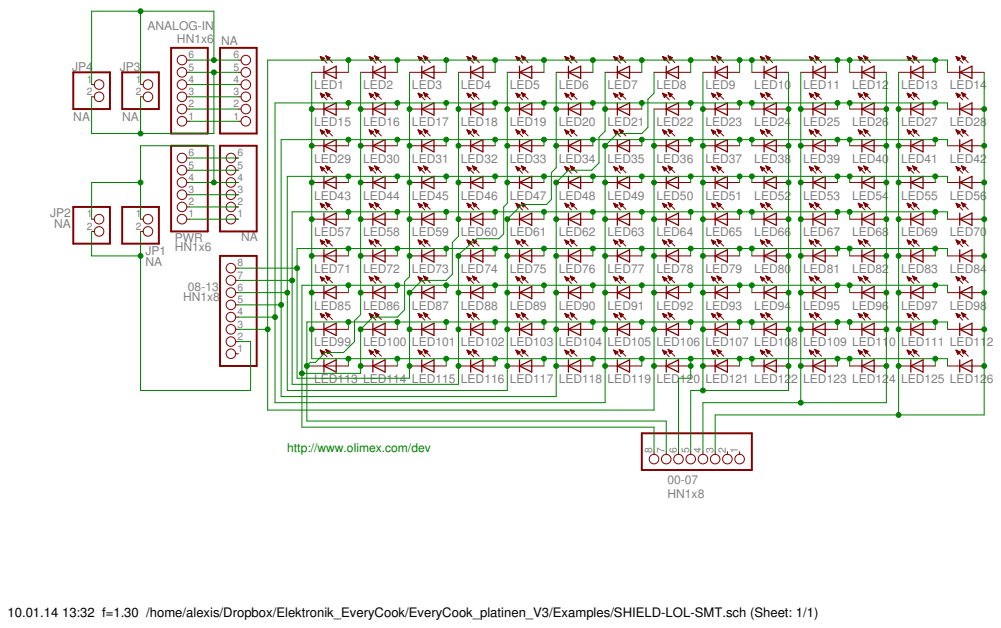
[picture p27: page 1]

http://www.olimex.com/dev

10.01.14 13:32 f=1.30 /home/alexis/Dropbox/Elektronik_EveryCook/EveryCook_platinen_V3/Examples/SHIELD-LOL-SMT.sch (Sheet: 1/1)
