everycook/EveryCook-PCB-layouts/ADC_LoadCell_Board/ADC_LoadCell_Board.brd

## EAGLE design ADC_LoadCell_Board/ADC_LoadCell_Board.brd (2014-08-21)

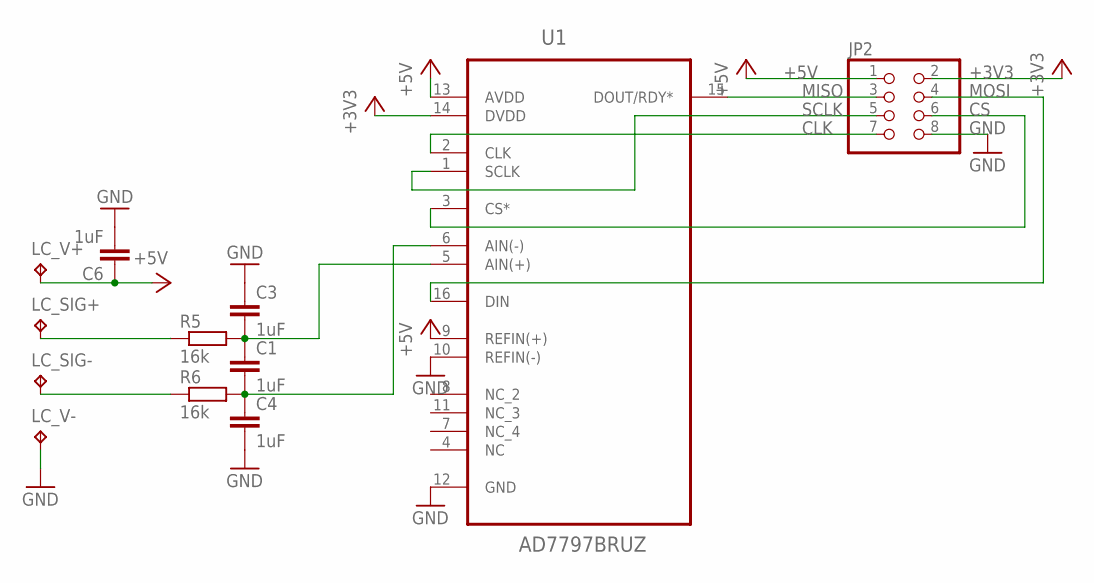
[picture p28: schematic ADC_LoadCell_Board.sch]

Parts:
C1, C3, C4, C6: 1uF; C0805
JP2: PINHD-2X4; 2X04
LC_SIG+: TPB1,27; B1,27
LC_SIG-: TPB1,27; B1,27
LC_V+: TPB1,27; B1,27
LC_V-: TPB1,27; B1,27
R5, R6: 16k; R0805
U1: AD7797BRUZ; SOP65P640X120-16N

Connections:
+3V3: JP2.2, U1.14 (DVDD)
+5V: C6.1, JP2.1, LC_V+.TP, U1.9 (REFIN(+)), U1.13 (AVDD)
CLK: JP2.7, U1.2 (CLK)
CS: JP2.6, U1.3 (CS*)
GND: C3.1, C4.2, C6.2, JP2.8, LC_V-.TP, U1.10 (REFIN(-)), U1.12 (GND)
MISO: JP2.3, U1.15 (DOUT/RDY*)
MOSI: JP2.4, U1.16 (DIN)
unnamed: LC_SIG+.TP, R5.1
unnamed: LC_SIG-.TP, R6.1
unnamed: C1.1, C3.2, R5.2, U1.5 (AIN(+))
unnamed: C1.2, C4.1, R6.2, U1.6 (AIN(-))
SCLK: JP2.5, U1.1 (SCLK)

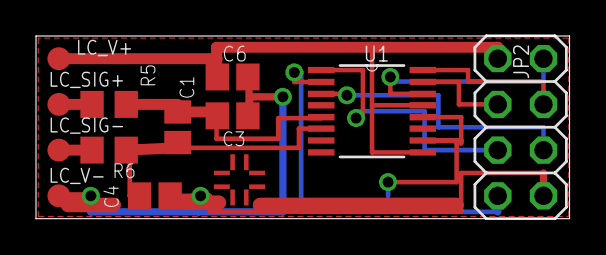
[picture p29: board ADC_LoadCell_Board.brd from above]

Board: 2 copper layers, 29.6 x 10.2 mm, 13 parts (0 on the bottom side), 12 nets.

Other parts of the board:
U$2: PASSER
