everycook/EveryCook-PCB-layouts/LoadCellAmp/LoadCellAmp.brd

## EAGLE design LoadCellAmp/LoadCellAmp.brd (2014-05-27)

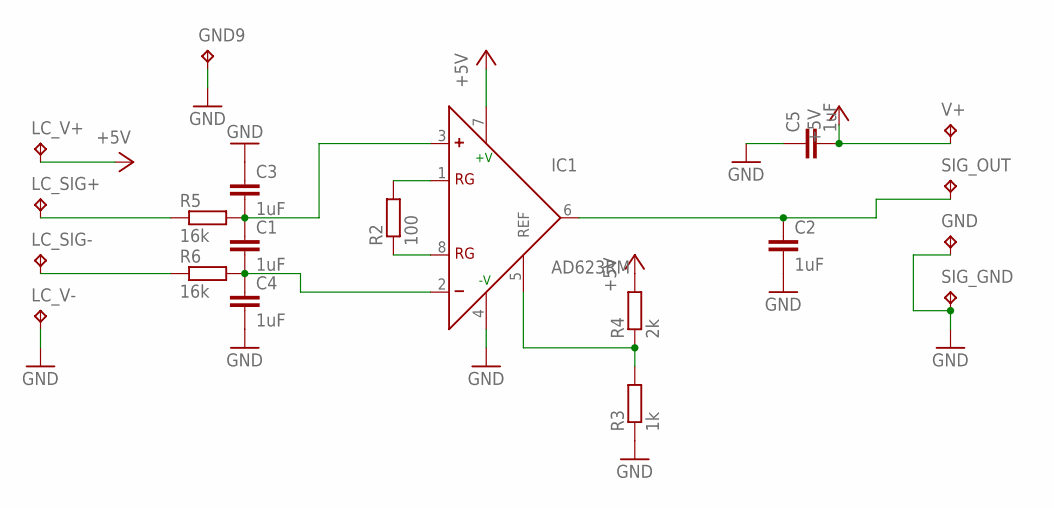
[picture p30: schematic LoadCellAmp.sch]

Parts:
C1, C2, C3, C4, C5: 1uF; C0805
GND, GND9: TPB1,27; B1,27
IC1: AD623RM; MSOP08
LC_SIG+: TPB1,27; B1,27
LC_SIG-: TPB1,27; B1,27
LC_V+: TPB1,27; B1,27
LC_V-: TPB1,27; B1,27
R2: 100; R0805
R3: 1k; R0805
R4: 2k; R0805
R5, R6: 16k; R0805
SIG_GND: TPB1,27; B1,27
SIG_OUT: TPB1,27; B1,27
V+: TPB1,27; B1,27

Connections:
+5V: C5.2, IC1.7 (+V), LC_V+.TP, R4.2, V+.TP
GND: C2.2, C3.1, C4.2, C5.1, GND.TP, GND9.TP, IC1.4 (-V), LC_V-.TP, R3.1, SIG_GND.TP
unnamed: IC1.1 (RG), R2.2
unnamed: IC1.8 (RG), R2.1
unnamed: IC1.5 (REF), R3.2, R4.1
unnamed: C2.1, IC1.6 (OUT), SIG_OUT.TP
unnamed: LC_SIG+.TP, R5.1
unnamed: LC_SIG-.TP, R6.1
unnamed: C1.1, C3.2, IC1.3 (+), R5.2
unnamed: C1.2, C4.1, IC1.2 (-), R6.2

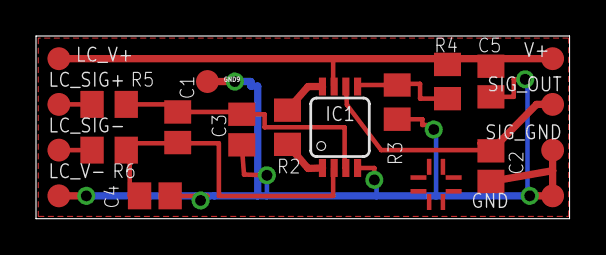
[picture p31: board LoadCellAmp.brd from above]

Board: 2 copper layers, 29.6 x 10.2 mm, 21 parts (0 on the bottom side), 10 nets.

Other parts of the board:
U$2: PASSER
