everycook/EveryCook-PCB-layouts/Mainboard/EveryCook_Mainboard.brd

## EAGLE design Mainboard/EveryCook_Mainboard.brd (2014-05-04)

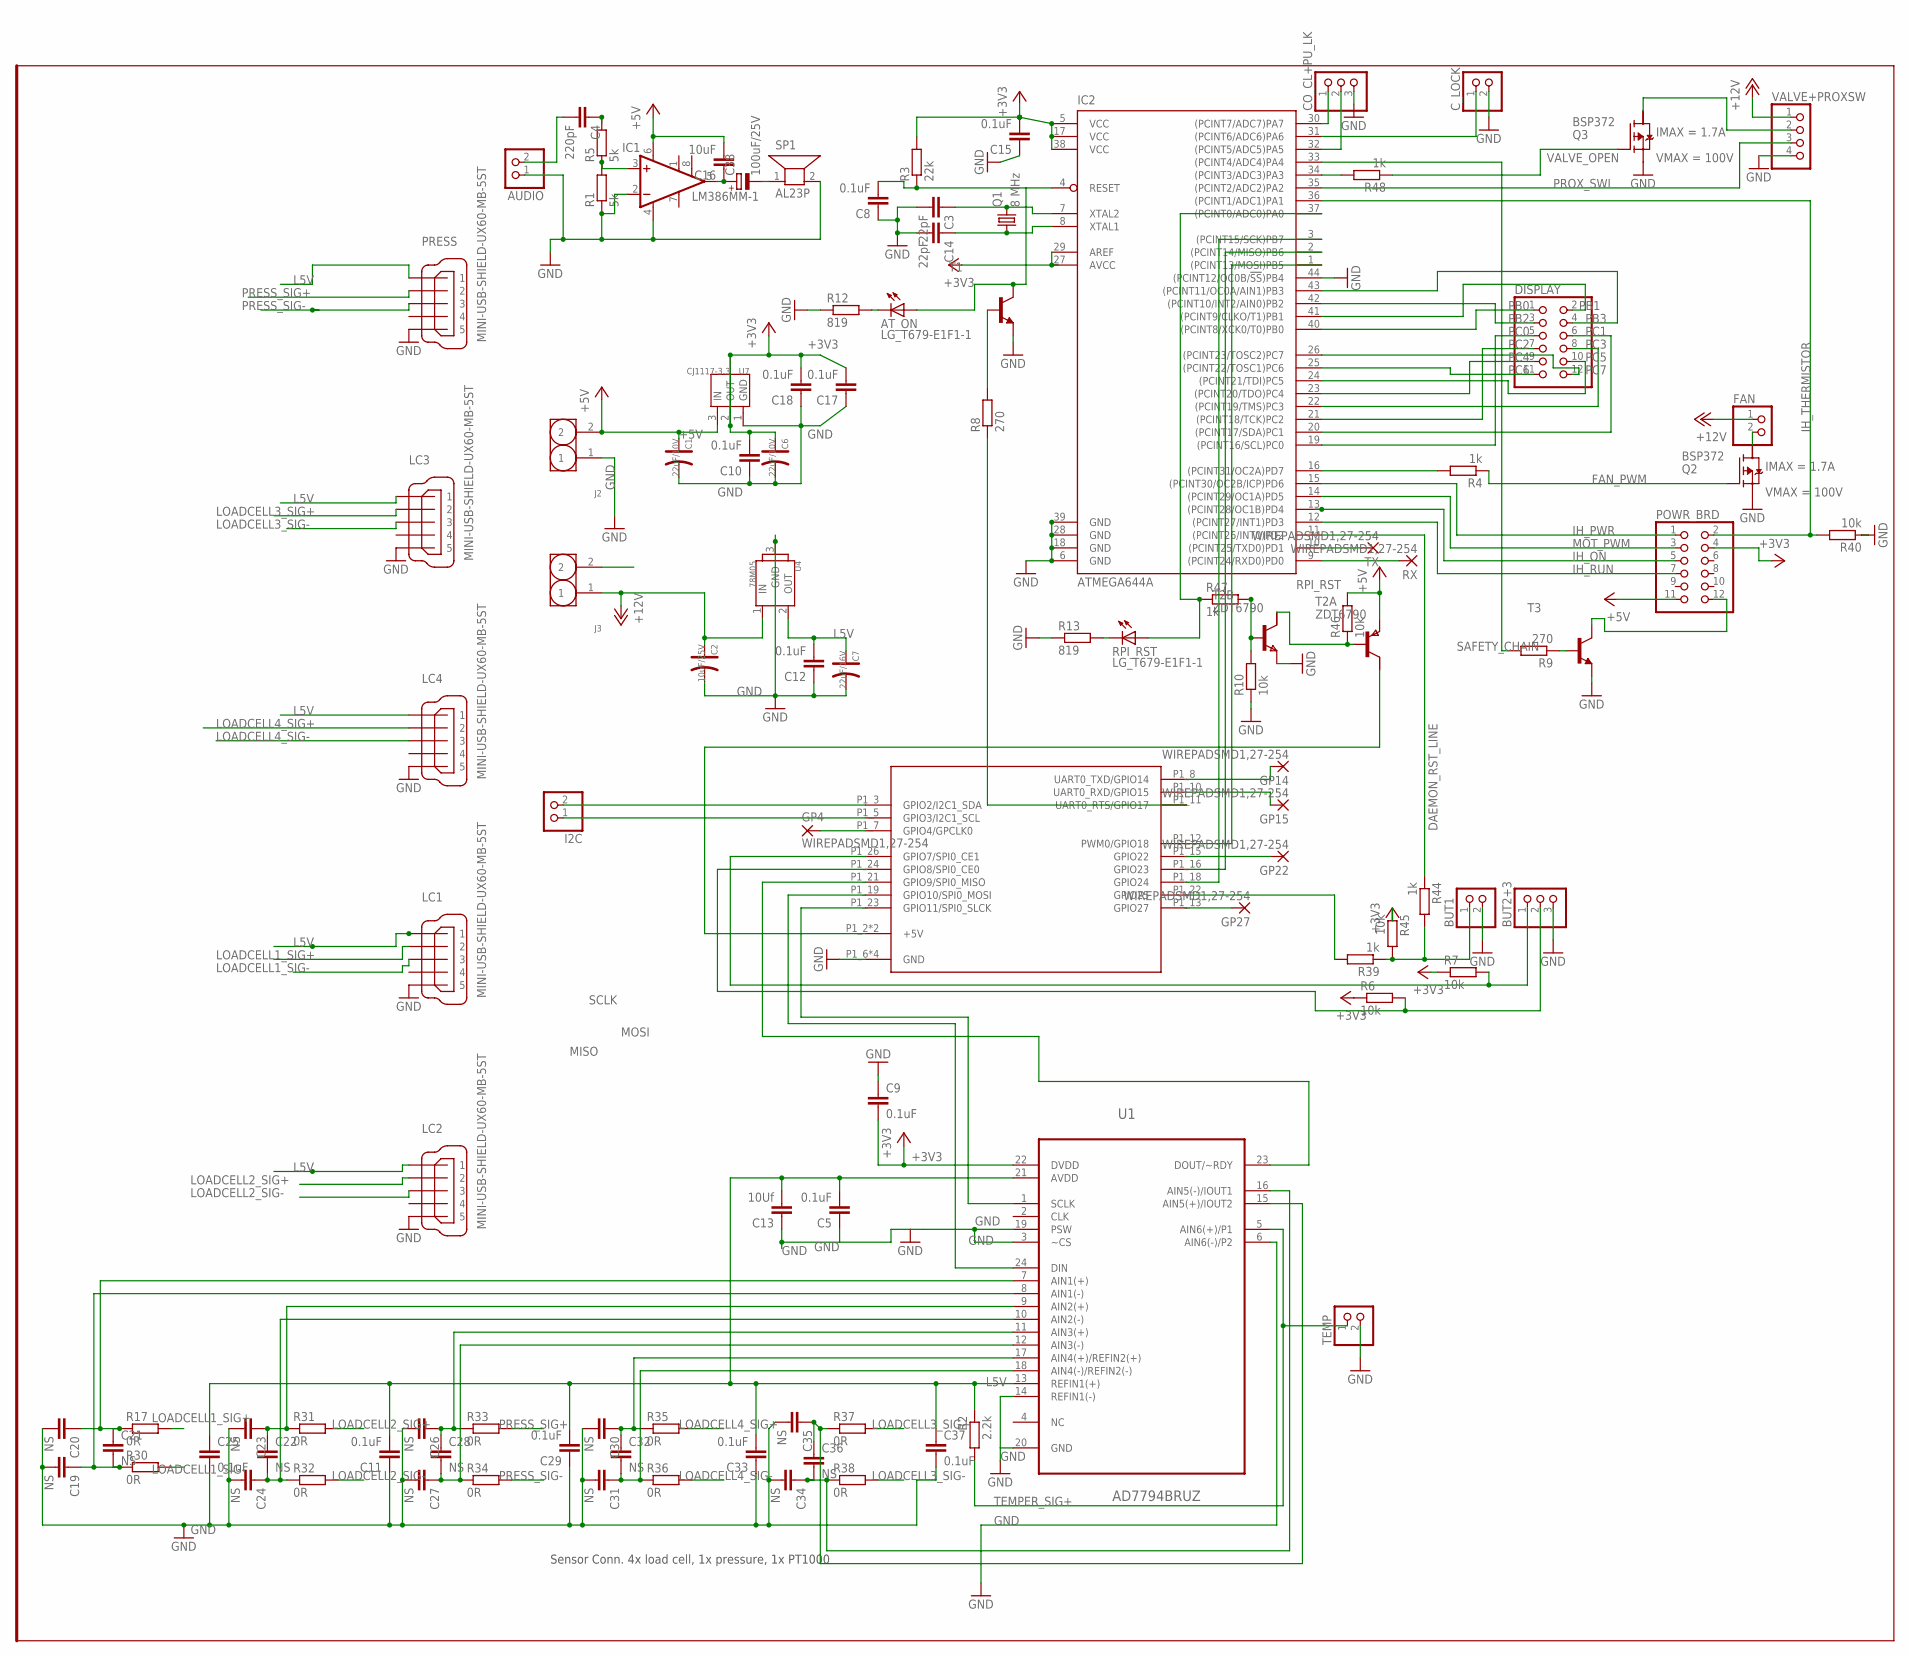
[picture p32: schematic EveryCook_Mainboard.sch]

Parts:
AT_ON: LG_T679-E1F1-1; PLCC2
AUDIO: PINHD-1X2; 1X02
BUT1: PINHD-1X2; 1X02
BUT2+3: PINHD-1X3; 1X03
C1, C6: 22uF/10V; AVX-A
C2: 10uF/25V; ELECTRO-SMD-B-4.8MM
C3, C14: 22pF; C0805
C4: 220pF; C0805
C5, C8, C9, C10, C11, C12, C15, C17, C18, C25, C29, C33, C37: 0.1uF; C0805
C7: 22uF/16V; ELECTRO-SMD-B-4.8MM
C13: 10Uf; C0805
C16: 10uF; C0805
C19, C20, C21, C22, C23, C24, C26, C27, C28, C30, C31, C32, C34, C35, C36: NS; C0805
C38: 100uF/25V; UD-6,3X7,7_NICHICON
CO_CL+PU_LK: PINHD-1X3; 1X03
C_LOCK: PINHD-1X2; 1X02
DISPLAY: PINHD-2X6; 2X06
FAN: PINHD-1X2; 1X02
GP4, GP14, GP15, GP22, GP27: WIREPADSMD1,27-254; SMD1,27-2,54
I2C: PINHD-1X2; 1X02
IC1: LM386MM-1; MMSOP08
IC2: ATMEGA644A; TQFP44
J2, J3: HEADER-2P-5.0; 2P-5.0
LC1, LC2, LC3, LC4: MINI-USB-SHIELD-UX60-MB-5ST; UX60-MB-5ST
POWR_BRD: PINHD-2X6; 2X06
PRESS: MINI-USB-SHIELD-UX60-MB-5ST; UX60-MB-5ST
Q1: 8 MHz; HC49UP
Q2, Q3: BSP372; PG-SOT-223
R1, R5: 5k; R0805
R2: 2.2k; R0805
R3: 22k; R0805
R4, R39, R44, R47, R48: 1k; R0805
R6, R7, R10, R40, R45, R46: 10k; R0805
R8, R9: 270; R0805
R12, R13: 819; R0805
R17, R30, R31, R32, R33, R34, R35, R36, R37, R38: 0R; R0805
RPI_RST: LG_T679-E1F1-1; PLCC2
RX: WIREPADSMD1,27-254; SMD1,27-2,54
SP1: AL23P
T1, T3: MMBT2222ALT1-NPN-SOT23-BEC; SOT23-BEC
T2: ZDT6790; SM8
TEMP: PINHD-1X2; 1X02
TX: WIREPADSMD1,27-254; SMD1,27-2,54
U1: AD7794BRUZ; SOP65P640X120-24N
U4: 78M05; TO252
U7: CJ1117-3.3; SOT89
U$5: RPI-B-V2
VALVE+PROXSW: PINHD-1X4; 1X04

Connections:
+3V3: C6.+, C9.2, C10.2, C15.2, C17.2, C18.2, IC2.5 (VCC), IC2.17 (VCC), IC2.27 (AVCC), IC2.29 (AREF), IC2.38 (VCC), POWR_BRD.4, R3.2, R6.1, R7.1, R45.1, U1.22 (DVDD), U7.2 (OUT), U7.4 (TAB)
+5V: C1.+, C16.2, IC1.6 (VS), J2.2, POWR_BRD.11, R46.2, T2.1 (E), U7.3 (IN)
+12V: C2.+, FAN.1, J3.1, U4.1 (IN), VALVE+PROXSW.1
ATMEL_RST: AT_ON.A, C8.2, IC2.4 (RESET), R3.1, T1.C
AT_MISO: IC2.2 ((PCINT14/MISO)PB6), U$5.P1_16 (GPIO23)
AT_MOSI: IC2.1 ((PCINT13/MOSI)PB5), U$5.P1_12 (PWM0/GPIO18)
C_CLOSE: CO_CL+PU_LK.1, IC2.30 ((PCINT7/ADC7)PA7)
DAEMON_RST_LINE: IC2.11 ((PCINT26/INT0)PD2), R44.1
FAN_PWM: Q2.1 (G), R4.1
GND: AUDIO.1, BUT1.2, BUT2+3.3, C1.-, C2.-, C3.2, C5.1, C6.-, C7.-, C8.1, C9.1, C10.1, C11.1, C12.1, C13.1, C14.2, C15.1, C17.1, C18.1, C19.2, C20.2, C23.2, C24.2, C25.2, C26.2, C27.2, C29.1, C30.2, C31.2, C33.1, C34.2, C35.2, C37.2, CO_CL+PU_LK.3, C_LOCK.2, IC1.2 (-IN), IC1.4 (GND), IC2.6 (GND), IC2.18 (GND), IC2.28 (GND), IC2.39 (GND), IC2.44 ((PCINT12/OC0B/!SS!)PB4), J2.1, LC1.5, LC2.5, LC3.5, LC4.5, PRESS.5, Q2.3 (S), Q3.3 (S), R1.1, R10.1, R12.1, R13.1, R40.1, SP1.2, T1.E, T2.3 (E), T3.E, TEMP.2, U1.3 (~CS), U1.6 (AIN6(-)/P2), U1.14 (REFIN1(-)), U1.19 (PSW), U1.20 (GND), U4.3 (GND), U7.1 (GND), U$5.P1_6 (GND), U$5.P1_14 (GND), U$5.P1_20 (GND), U$5.P1_25 (GND), VALVE+PROXSW.4
IH_ON: IC2.13 ((PCINT28/OC1B)PD4), POWR_BRD.5
IH_PWR: IC2.15 ((PCINT30/OC2B/ICP)PD6), POWR_BRD.1
IH_RUN: IC2.12 ((PCINT27/INT1)PD3), POWR_BRD.7
IH_THERMISTOR: IC2.36 ((PCINT1/ADC1)PA1), POWR_BRD.2, R40.2
L5V: C5.2, C7.+, C11.2, C12.2, C13.2, C25.1, C29.2, C33.2, C37.1, LC1.1, LC2.1, LC3.1, LC4.1, PRESS.1, R2.1, U1.13 (REFIN1(+)), U1.21 (AVDD), U4.2 (OUT)
LOADCELL1_SIG+: LC1.2, R17.2
LOADCELL1_SIG-: LC1.3, R30.2
LOADCELL2_SIG+: LC2.2, R31.2
LOADCELL2_SIG-: LC2.3, R32.2
LOADCELL3_SIG+: LC3.2, R37.2
LOADCELL3_SIG-: LC3.3, R38.2
LOADCELL4_SIG+: LC4.2, R35.2
LOADCELL4_SIG-: LC4.3, R36.2
MISO: U1.23 (DOUT/~RDY), U$5.P1_21 (GPIO9/SPI0_MISO)
MOSI: U1.24 (DIN), U$5.P1_19 (GPIO10/SPI0_MOSI)
MOT_PWM: IC2.14 ((PCINT29/OC1A)PD5), POWR_BRD.3
unnamed: I2C.1, U$5.P1_5 (GPIO3/I2C1_SCL)
unnamed: C3.1, IC2.7 (XTAL2), Q1.2
unnamed: C4.1, R5.2
unnamed: C34.1, C36.2, R38.1, U1.16 (AIN5(-)/IOUT1)
unnamed: I2C.2, U$5.P1_3 (GPIO2/I2C1_SDA)
unnamed: C14.1, IC2.8 (XTAL1), Q1.1
unnamed: POWR_BRD.12, T3.C
unnamed: C20.1, C21.1, R17.1, U1.7 (AIN1(+))
unnamed: IC2.16 ((PCINT31/OC2A)PD7), R4.2
unnamed: R9.1, T3.B
unnamed: IC2.10 ((PCINT25/TXD0)PD1), TX.1
unnamed: IC1.3 (+IN), R1.2, R5.1
unnamed: IC2.9 ((PCINT24/RXD0)PD0), RX.1
unnamed: GP4.1, U$5.P1_7 (GPIO4/GPCLK0)
unnamed: GP27.1, U$5.P1_13 (GPIO27)
unnamed: GP22.1, U$5.P1_15 (GPIO22)
unnamed: GP15.1, U$5.P1_10 (UART0_RXD/GPIO15)
unnamed: GP14.1, U$5.P1_8 (UART0_TXD/GPIO14)
unnamed: C16.1, C38.+, IC1.5 (OUT)
unnamed: C38.-, SP1.1
unnamed: C22.1, C23.1, R31.1, U1.9 (AIN2(+))
unnamed: R8.2, T1.B
unnamed: AUDIO.2, C4.2
unnamed: AT_ON.C, R12.2
unnamed: R13.2, RPI_RST.C
unnamed: C22.2, C24.1, R32.1, U1.10 (AIN2(-))
unnamed: C27.1, C28.2, R34.1, U1.12 (AIN3(-))
unnamed: C30.1, C32.1, R35.1, U1.17 (AIN4(+)/REFIN2(+))
unnamed: C31.1, C32.2, R36.1, U1.18 (AIN4(-)/REFIN2(-))
unnamed: C35.1, C36.1, R37.1, U1.15 (AIN5(+)/IOUT2)
unnamed: C19.1, C21.2, R30.1, U1.8 (AIN1(-))
unnamed: FAN.2, Q2.2 (D)
unnamed: C26.1, C28.1, R33.1, U1.11 (AIN3(+))
unnamed: T2.8 (C1), U$5.P1_2 (+5V), U$5.P1_4 (+5V)
unnamed: C_LOCK.1, IC2.31 ((PCINT6/ADC6)PA6)
unnamed: BUT2+3.1, R7.2, U$5.P1_26 (GPIO7/SPI0_CE1)
unnamed: BUT2+3.2, R6.2, U$5.P1_24 (GPIO8/SPI0_CE0)
unnamed: R39.2, U$5.P1_22 (GPIO25)
unnamed: IC2.34 ((PCINT3/ADC3)PA3), R48.2
unnamed: BUT1.1, R39.1, R44.2, R45.2
unnamed: R10.2, R47.2, T2.4 (B)
unnamed: R46.1, T2.2 (B), T2.5 (C1)
unnamed: Q3.2 (D), VALVE+PROXSW.2
PB0: DISPLAY.1, IC2.40 ((PCINT8/XCK0/T0)PB0)
PB1: DISPLAY.2, IC2.41 ((PCINT9/CLKO/T1)PB1)
PB2: DISPLAY.3, IC2.42 ((PCINT10/INT2/AIN0)PB2)
PB3: DISPLAY.4, IC2.43 ((PCINT11/OC0A/AIN1)PB3)
PC0: DISPLAY.5, IC2.19 ((PCINT16/SCL)PC0)
PC1: DISPLAY.6, IC2.20 ((PCINT17/SDA)PC1)
PC2: DISPLAY.7, IC2.21 ((PCINT18/TCK)PC2)
PC3: DISPLAY.8, IC2.22 ((PCINT19/TMS)PC3)
PC4: DISPLAY.9, IC2.23 ((PCINT20/TDO)PC4)
PC5: DISPLAY.10, IC2.24 ((PCINT21/TDI)PC5)
PC6: DISPLAY.11, IC2.25 ((PCINT22/TOSC1)PC6)
PC7: DISPLAY.12, IC2.26 ((PCINT23/TOSC2)PC7)
PGND: J3.2
PRESS_SIG+: PRESS.2, R33.2
PRESS_SIG-: PRESS.3, R34.2
PROX_SWI: IC2.35 ((PCINT2/ADC2)PA2), VALVE+PROXSW.3
P_LOCK: CO_CL+PU_LK.2, IC2.32 ((PCINT5/ADC5)PA5)
RPI_ATMEL_RST: R8.1, U$5.P1_11 (UART0_RTS/GPIO17)
RPI_RST: IC2.37 ((PCINT0/ADC0)PA0), R47.1, RPI_RST.A
SAFETY_CHAIN: IC2.33 ((PCINT4/ADC4)PA4), R9.2
SCK: IC2.3 ((PCINT15/SCK)PB7), U$5.P1_18 (GPIO24)
SCLK: U1.1 (SCLK), U$5.P1_23 (GPIO11/SPI0_SLCK)
TEMPER_SIG+: R2.2, TEMP.1, U1.5 (AIN6(+)/P1)
VALVE_OPEN: Q3.1 (G), R48.1

Notes on the sheet:
Sensor Conn. 4x load cell, 1x pressure, 1x PT1000

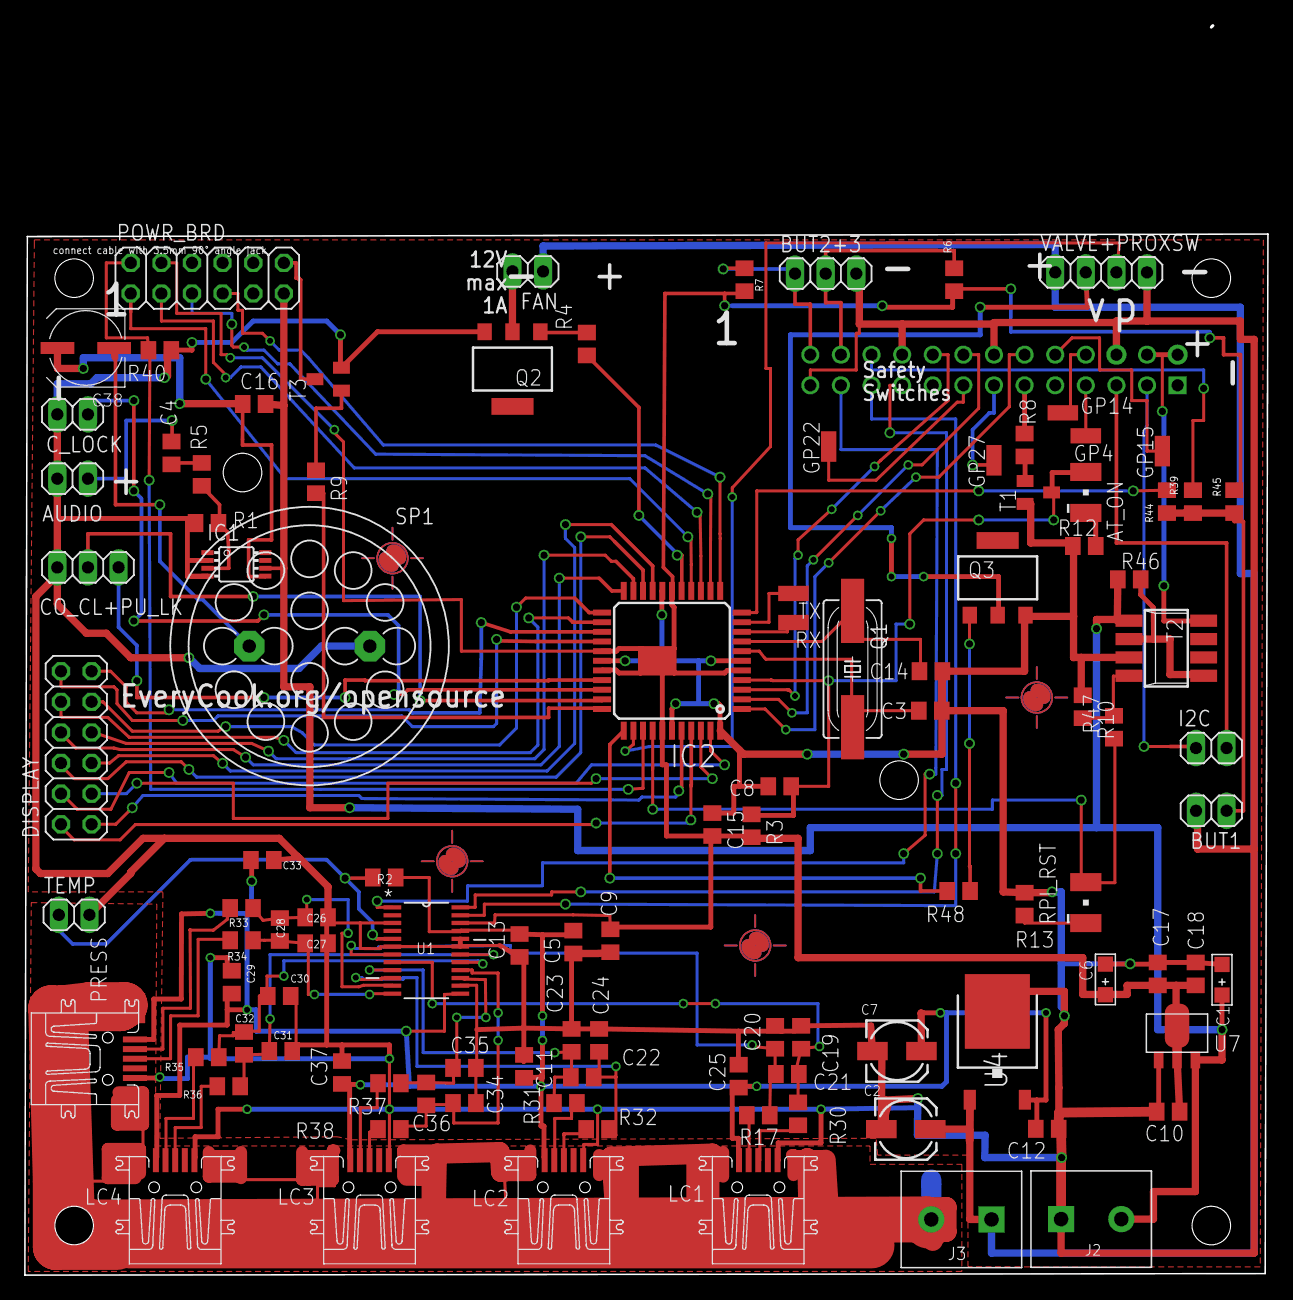
[picture p33: board EveryCook_Mainboard.brd from above]

Board: 2 copper layers, 103.1 x 86.4 mm, 111 parts (0 on the bottom side), 92 nets.

Other parts of the board:
U$1, U$2, U$3, U$4: PASS-ROUND
