everycook/EveryCook-PCB-layouts/SafetyChain/SafetyChain.brd

## EAGLE design SafetyChain/SafetyChain.brd (2014-02-05)

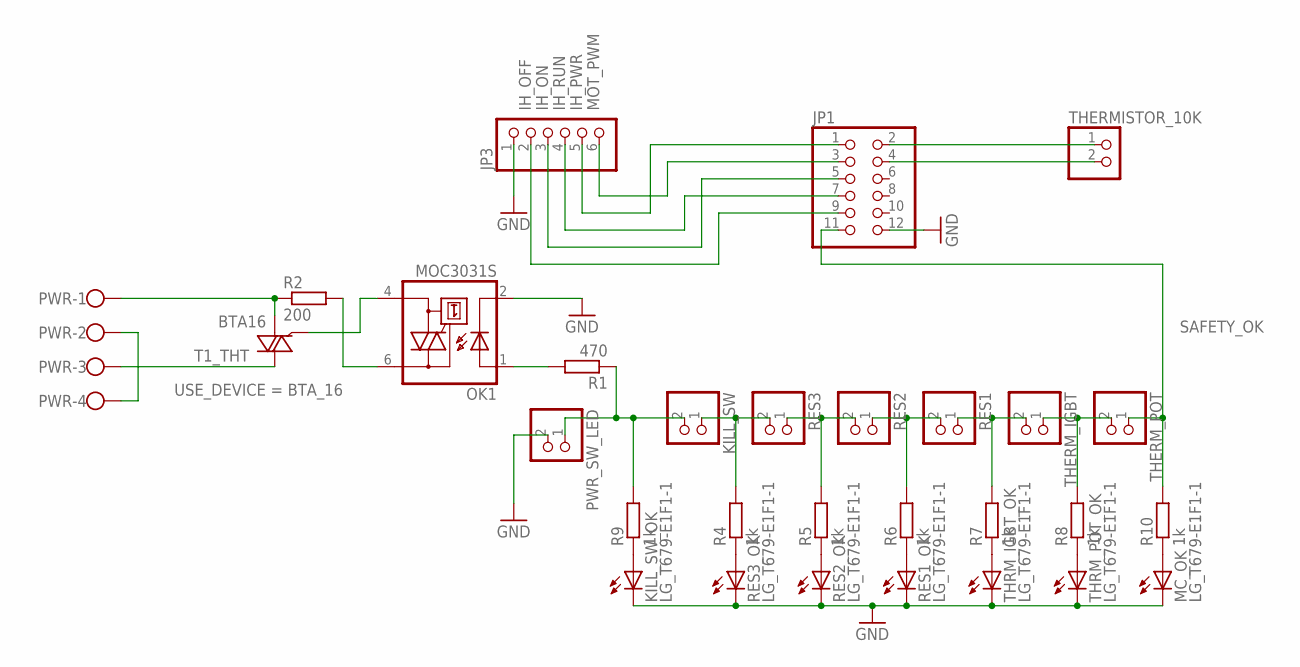
[picture p34: schematic SafetyChain.sch]

Parts:
JP1: PINHD-2X6; 2X06
JP3: PINHD-1X6; 1X06
KILL_SW: PINHD-1X2; 1X02
KILL_SW_OK: LG_T679-E1F1-1; PLCC2
MC_OK: LG_T679-E1F1-1; PLCC2
OK1: MOC3031S; DIL6-SMD
PWR: W237-4
PWR_SW_LED: PINHD-1X2; 1X02
R1: 470; M0805
R2: 200; M0805
R4, R5, R6, R7, R8, R9, R10: 1k; M0805
RES1, RES2, RES3: PINHD-1X2; 1X02
RES1_OK, RES2_OK, RES3_OK: LG_T679-E1F1-1; PLCC2
T1_THT: BTA16; TO220BV
THERMISTOR_10K: PINHD-1X2; 1X02
THERM_IGBT: PINHD-1X2; 1X02
THERM_POT: PINHD-1X2; 1X02
THRM_IGBT_OK: LG_T679-E1F1-1; PLCC2
THRM_POT_OK: LG_T679-E1F1-1; PLCC2

Connections:
3V3: JP1.4, THERMISTOR_10K.2
GND: JP1.12, JP3.1, KILL_SW_OK.C, MC_OK.C, OK1.2 (C), PWR_SW_LED.2, RES1_OK.C, RES2_OK.C, RES3_OK.C, THRM_IGBT_OK.C, THRM_POT_OK.C
IH_OFF: JP1.9, JP3.2
IH_ON: JP1.5, JP3.3
IH_PWR: JP1.1, JP3.5
IH_RUN: JP1.7, JP3.4
IH_THERMISTOR: JP1.2, THERMISTOR_10K.1
L_IN: PWR.1, R2.1, T1_THT.T1 (A1)
L_OUT: PWR.3, T1_THT.T2 (A2)
MOT_PWM: JP1.3, JP3.6
unnamed: OK1.1 (A), R1.2
unnamed: OK1.6 (A2), R2.2
unnamed: R8.2, THERM_IGBT.1, THERM_POT.2
unnamed: R7.2, RES1.1, THERM_IGBT.2
unnamed: R6.2, RES1.2, RES2.1
unnamed: R5.2, RES2.2, RES3.1
unnamed: KILL_SW.1, R4.2, RES3.2
unnamed: KILL_SW.2, PWR_SW_LED.1, R1.1, R9.2
unnamed: R4.1, RES3_OK.A
unnamed: R5.1, RES2_OK.A
unnamed: R6.1, RES1_OK.A
unnamed: R7.1, THRM_IGBT_OK.A
unnamed: R8.1, THRM_POT_OK.A
unnamed: MC_OK.A, R10.1
unnamed: KILL_SW_OK.A, R9.1
PWR_N: PWR.2, PWR.4
SAFETY_OK: JP1.11, R10.2, THERM_POT.1
TRIAC_DRV: OK1.4 (A1), T1_THT.G

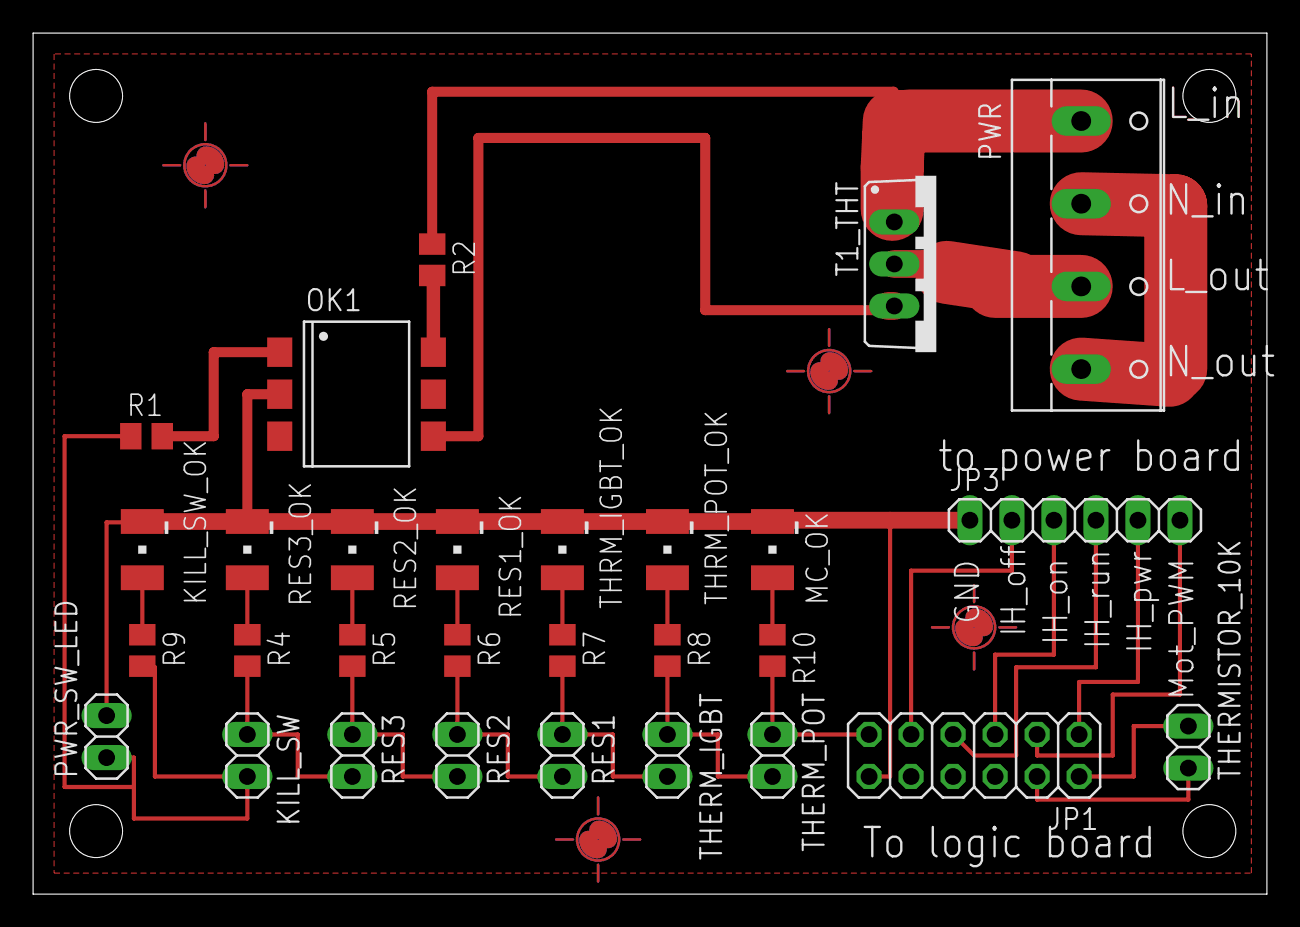
[picture p35: board SafetyChain.brd from above]

Board: 2 copper layers, 74.6 x 52.1 mm, 33 parts (0 on the bottom side), 28 nets.

Other parts of the board:
U$1, U$2, U$3, U$4: PASS-ROUND
