everycook/EveryCook-PCB-layouts/Display/Display_EveryCook.brd

## EAGLE design Display/Display_EveryCook.brd (2014-02-05)

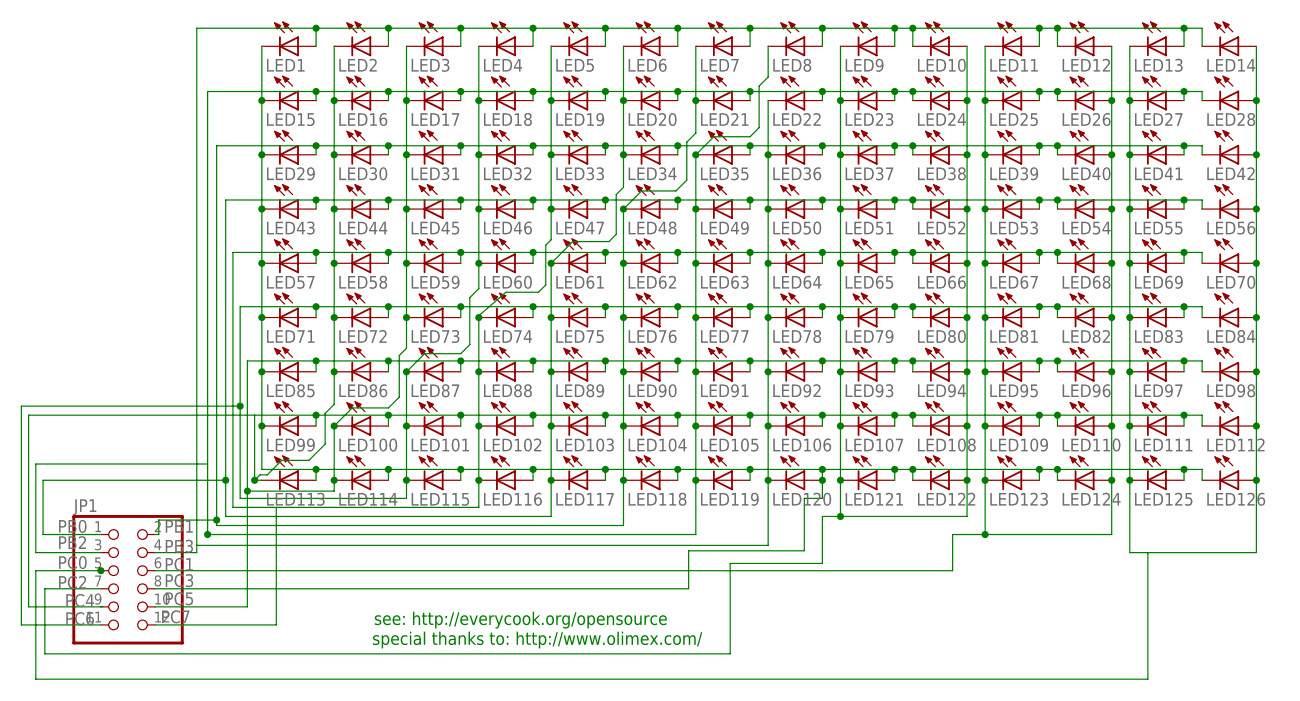
[picture p36: schematic Display_EveryCook.sch]

Parts:
JP1: PINHD-2X6; 2X06
LED1, LED2, LED3, LED4, LED5, LED6, LED7, LED8, LED9, LED10, LED11, LED12, LED13, LED14, LED15, LED16, LED17, LED18, LED19, LED20, LED21, LED22, LED23, LED24, LED25, LED26, LED27, LED28, LED29, LED30, LED31, LED32, LED33, LED34, LED35, LED36, LED37, LED38, LED39, LED40, LED41, LED42, LED43, LED44, LED45, LED46, LED47, LED48, LED49, LED50, LED51, LED52, LED53, LED54, LED55, LED56, LED57, LED58, LED59, LED60, LED61, LED62, LED63, LED64, LED65, LED66, LED67, LED68, LED69, LED70, LED71, LED72, LED73, LED74, LED75, LED76, LED77, LED78, LED79, LED80, LED81, LED82, LED83, LED84, LED85, LED86, LED87, LED88, LED89, LED90, LED91, LED92, LED93, LED94, LED95, LED96, LED97, LED98, LED99, LED100, LED101, LED102, LED103, LED104, LED105, LED106, LED107, LED108, LED109, LED110, LED111, LED112, LED113, LED114, LED115, LED116, LED117, LED118, LED119, LED120, LED121, LED122, LED123, LED124, LED125, LED126: LEDKA-3528ASYC; KA-3528ASYC

Connections:
PB0: JP1.1, LED6.C, LED20.C, LED34.C, LED43.A, LED44.A, LED45.A, LED46.A, LED47.A, LED48.A, LED49.A, LED50.A, LED51.A, LED52.C, LED53.A, LED54.C, LED55.A, LED56.C, LED61.C, LED75.C, LED89.C, LED103.C, LED117.C
PB1: JP1.2, LED7.C, LED21.C, LED29.A, LED30.A, LED31.A, LED32.A, LED33.A, LED34.A, LED35.A, LED36.A, LED37.A, LED38.C, LED39.A, LED40.C, LED41.A, LED42.C, LED48.C, LED62.C, LED76.C, LED90.C, LED104.C, LED118.C
PB2: JP1.3, LED8.C, LED15.A, LED16.A, LED17.A, LED18.A, LED19.A, LED20.A, LED21.A, LED22.A, LED23.A, LED24.C, LED25.A, LED26.C, LED27.A, LED28.C, LED35.C, LED49.C, LED63.C, LED77.C, LED91.C, LED105.C, LED119.C
PB3: JP1.4, LED1.A, LED2.A, LED3.A, LED4.A, LED5.A, LED6.A, LED7.A, LED8.A, LED9.A, LED10.C, LED11.A, LED12.C, LED13.A, LED14.C, LED22.C, LED36.C, LED50.C, LED64.C, LED78.C, LED92.C, LED106.C, LED120.C
PC0: JP1.5, LED13.C, LED14.A, LED27.C, LED28.A, LED41.C, LED42.A, LED55.C, LED56.A, LED69.C, LED70.A, LED83.C, LED84.A, LED97.C, LED98.A, LED111.C, LED112.A, LED125.C, LED126.A
PC1: JP1.6, LED11.C, LED12.A, LED25.C, LED26.A, LED39.C, LED40.A, LED53.C, LED54.A, LED67.C, LED68.A, LED81.C, LED82.A, LED95.C, LED96.A, LED109.C, LED110.A, LED123.C, LED124.A
PC2: JP1.7, LED9.C, LED10.A, LED23.C, LED24.A, LED37.C, LED38.A, LED51.C, LED52.A, LED65.C, LED66.A, LED79.C, LED80.A, LED93.C, LED94.A, LED107.C, LED108.A, LED121.C, LED122.A
PC3: JP1.8, LED1.C, LED15.C, LED29.C, LED43.C, LED57.C, LED71.C, LED85.C, LED99.C, LED113.A, LED114.A, LED115.A, LED116.A, LED117.A, LED118.A, LED119.A, LED120.A, LED121.A, LED122.C, LED123.A, LED124.C, LED125.A, LED126.C
PC4: JP1.9, LED2.C, LED16.C, LED30.C, LED44.C, LED58.C, LED72.C, LED86.C, LED99.A, LED100.A, LED101.A, LED102.A, LED103.A, LED104.A, LED105.A, LED106.A, LED107.A, LED108.C, LED109.A, LED110.C, LED111.A, LED112.C, LED113.C
PC5: JP1.10, LED3.C, LED17.C, LED31.C, LED45.C, LED59.C, LED73.C, LED85.A, LED86.A, LED87.A, LED88.A, LED89.A, LED90.A, LED91.A, LED92.A, LED93.A, LED94.C, LED95.A, LED96.C, LED97.A, LED98.C, LED100.C, LED114.C
PC6: JP1.11, LED4.C, LED18.C, LED32.C, LED46.C, LED60.C, LED71.A, LED72.A, LED73.A, LED74.A, LED75.A, LED76.A, LED77.A, LED78.A, LED79.A, LED80.C, LED81.A, LED82.C, LED83.A, LED84.C, LED87.C, LED101.C, LED115.C
PC7: JP1.12, LED5.C, LED19.C, LED33.C, LED47.C, LED57.A, LED58.A, LED59.A, LED60.A, LED61.A, LED62.A, LED63.A, LED64.A, LED65.A, LED66.C, LED67.A, LED68.C, LED69.A, LED70.C, LED74.C, LED88.C, LED102.C, LED116.C

Notes on the sheet:
special thanks to: http://www.olimex.com/
see: http://everycook.org/opensource

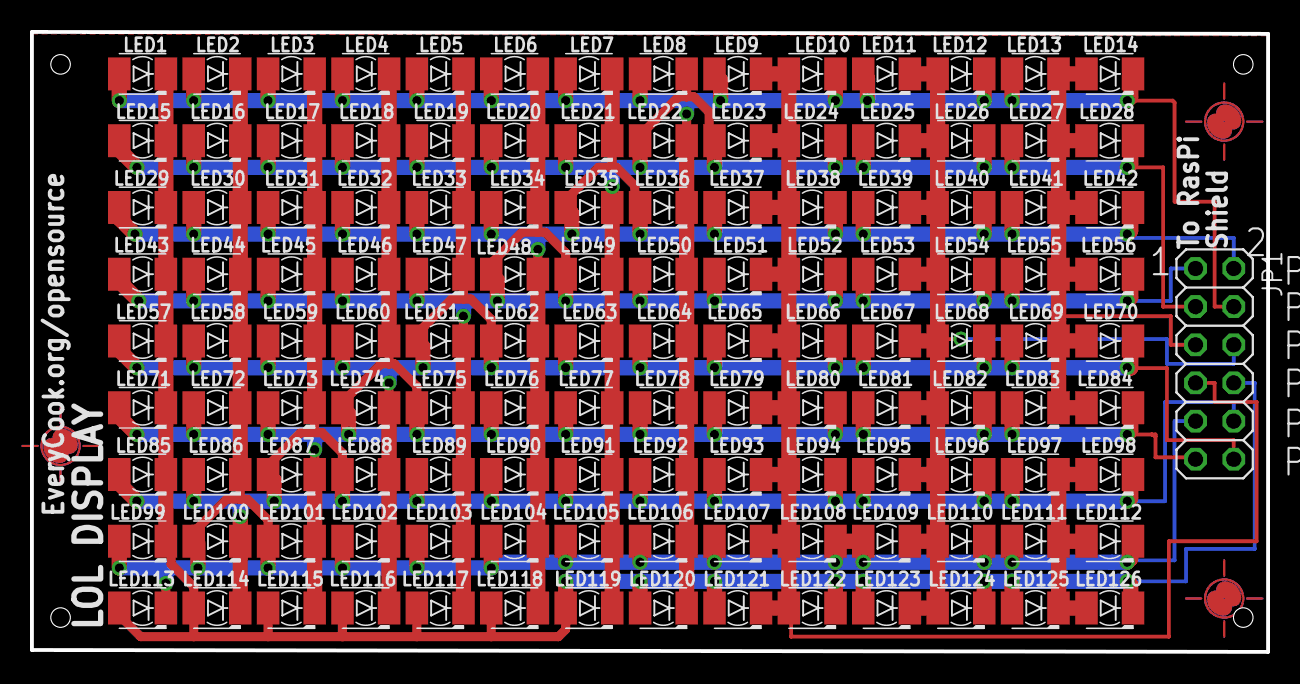
[picture p37: board Display_EveryCook.brd from above]

Board: 2 copper layers, 82.3 x 41.3 mm, 130 parts (0 on the bottom side), 12 nets.

Other parts of the board:
U$1, U$2, U$3: PASS-ROUND
