everycook/EveryCook-PCB-layouts/IH/EveryCookPWR.brd

## EAGLE design IH/EveryCookPWR.brd (2014-04-16)

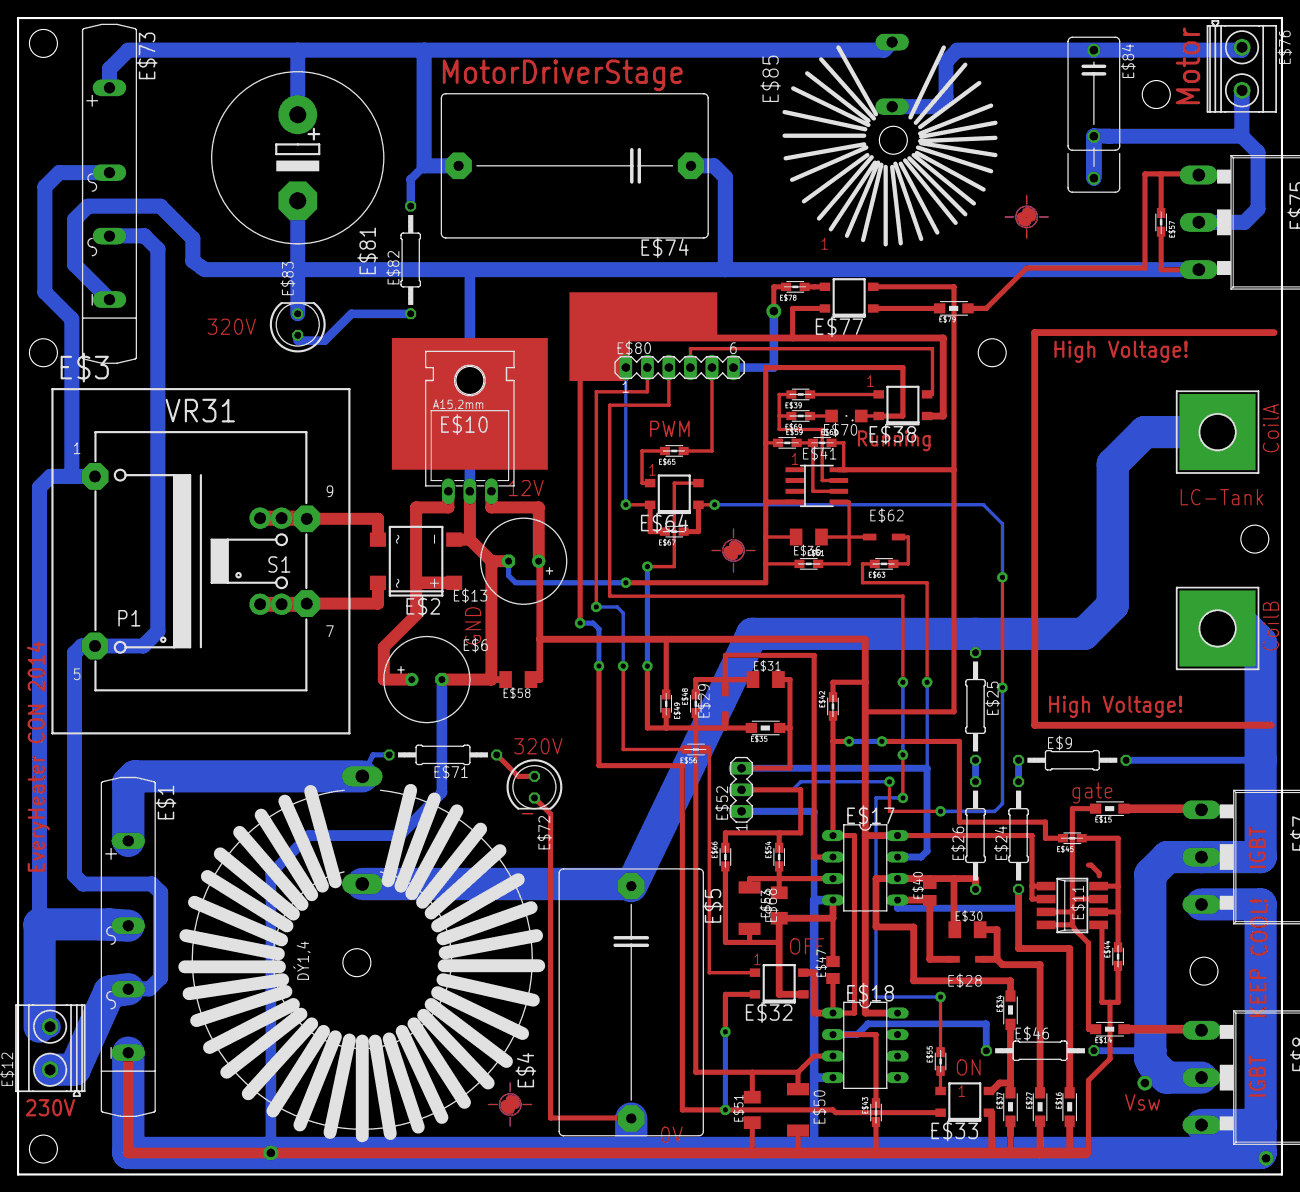
[picture p38: board EveryCookPWR.brd from above]

Board: 2 copper layers, 149.2 x 136.5 mm, 85 parts (0 on the bottom side), 51 nets.

Parts:
E$1, E$73: GBI25M; SKB50
E$2: DBS
E$3: VR31
E$4: 330uH (SDO-40-5.00-330); ED43
E$5, E$74: 6.8uF (B32674D4685K000); C27.5B17
E$6, E$13: 220uF; E3,5-10
E$7, E$8, E$75: FGA25120N; TO247BH
E$9, E$24: 300k; 0207/12
E$10: 7812; 78XXL_S
E$11: ZDT6790; SM8
E$12, E$76: MKDSN1,5/2-5,08
E$14, E$15: 10; 1206
E$16: 6k8; 1206
E$17, E$18: LM2903N; DIL8
E$19, E$20: 4,1-PAD-SQUARE
E$21, E$22, E$23: PASS-ROUND
E$25, E$26: 330k; 0207/12
E$27: 22k; 1206
E$28, E$29, E$62: SOD123
E$30: 1n; C1206K
E$31: 2nF; C1206K
E$32, E$33, E$38, E$64, E$77: HCPL181; TO-269AA
E$34, E$35: 1k; 1206
E$36, E$58: 1uF; C1206K
E$37: 8k2; 1206
E$39, E$55, E$56, E$59, E$65, E$69, E$78: 1k; 0805
E$40, E$47: 150p; C0805K
E$41: LMV6482; SO8
E$42, E$43, E$54, E$57, E$67: 4k7; 0805
E$44, E$60, E$63, E$66: 10k; 0805
E$45: 470; 0805
E$46: 680k; 0207/12
E$48, E$61: 22k; 0805
E$49: 270; 0805
E$50, E$68: Z5.1; MELF-MLL41
E$51, E$53: 10uF; C1206K
E$52: MA03-1
E$70: SML1206
E$71, E$82: 100k; 0207/12
E$72, E$83: LED5MM
E$79: 100; 1206
E$80: MA06-1
E$81: 47uF; EB20D
E$84: C102_152-062X184
E$85: L-160

Connections:
S$1: E$1.AC1, E$3.1, E$12.2, E$73.AC1
S$2: E$3.5, E$73.AC2
S$3: E$9.1, E$24.2
S$4: E$1.+, E$4.1, E$71.2
S$5: E$4.2, E$5.1, E$20.B4,1, E$25.1
S$6: E$2.AC2, E$3.9
S$7: E$2.AC1, E$3.7
S$8: E$65.2, E$80.5
S$9: E$2.+, E$6.+, E$10.IN
S$10: E$16.1, E$17.5, E$24.1, E$28.2, E$40.1
S$11: E$7.G, E$15.2
S$12: E$7.D, E$8.D, E$9.2, E$19.B4,1, E$46.2
S$13: E$8.G, E$14.2
S$14: E$11.3, E$11.4, E$11.7, E$14.1, E$15.1
S$15: E$11.6, E$11.8, E$44.1, E$45.2
S$16: E$10.OUT, E$11.1, E$11.2, E$13.+, E$17.8, E$18.8, E$41.8, E$42.1, E$49.2, E$58.1, E$60.1, E$77.-
S$17: E$25.2, E$26.2
S$18: E$27.1, E$28.1, E$30.2
S$19: E$17.6, E$26.1, E$30.1, E$34.1, E$40.2
S$20: E$33.-, E$34.2, E$37.1
S$21: E$17.1, E$18.1, E$32.-, E$42.2, E$45.1, E$47.1
S$22: E$41.6, E$59.1, E$60.2
S$23: E$18.2, E$43.1, E$46.1
S$24: E$17.2, E$29.2, E$31.1, E$48.1
S$25: E$18.3, E$29.1, E$35.1, E$48.2, E$49.1, E$50.1, E$51.2, E$64.-
S$26: E$17.3, E$53.2, E$54.2, E$68.1
S$27: E$32.AC1, E$33.AC1, E$38.+, E$64.AC1, E$67.1, E$77.AC1, E$80.1
S$28: E$33.AC2, E$55.2
S$29: E$32.AC2, E$56.2
S$30: E$55.1, E$80.3
S$31: E$17.7, E$31.2, E$35.2, E$52.3, E$63.1
S$32: E$52.2, E$54.1, E$64.+, E$66.1, E$67.2
S$33: E$56.1, E$80.2
S$34: E$38.-, E$80.4
S$36: E$38.AC2, E$39.2
S$37: E$39.1, E$41.7, E$69.1
S$38: E$1.-, E$2.-, E$5.2, E$6.-, E$7.S, E$8.S, E$10.GND, E$11.5, E$13.-, E$16.2, E$17.4, E$18.4, E$27.2, E$32.+, E$33.+, E$36.2, E$37.2, E$38.AC1, E$41.4, E$43.2, E$44.2, E$47.2, E$50.2, E$51.1, E$52.1, E$53.1, E$57.1, E$58.2, E$59.2, E$61.2, E$66.2, E$68.2, E$70.C, E$72.K, E$73.-, E$74.1, E$75.S, E$81.-, E$83.K
S$39: E$36.1, E$41.5, E$61.1, E$62.1
S$40: E$62.2, E$63.2
S$41: E$64.AC2, E$65.1
S$47: E$69.2, E$70.A
S$48: E$71.1, E$72.A
S$52: E$73.+, E$74.2, E$81.+, E$82.2, E$85.1
S$53: E$77.+, E$79.1
S$54: E$57.2, E$75.G, E$79.2
S$55: E$1.AC2, E$12.1
S$56: E$77.AC2, E$78.2
S$57: E$78.1, E$80.6
S$58: E$82.1, E$83.A
S$60: E$75.D, E$76.2, E$84.2, E$84.3
S$61: E$76.1, E$84.1, E$85.2
