everycook/EveryCook-PCB-layouts/(commit log)

2014-01-07 The first commit of the V3 EveryCook boards
    [EveryCookPWR.brd, EveryCook_RaspiShield_V3.brd, EveryCook_RaspiShield_V3.sch, EveryCook_boards_spec.ods, LeoStick.brd, LeoStick.sch, SHIELD-LOL-SMT.brd, SHIELD-LOL-SMT.sch]
2014-01-07 Corrected URL on board (very important!) ;-)
    [SHIELD-LOL-SMT_EveryCook.brd]
2014-01-07 Description for connector
2014-01-10 Schematic of logic board finished, only audio amp missing. Board ripped up for redraw
    [EveryCook_RaspiShield_V3.brd, EveryCook_RaspiShield_V3.sch, EveryCook_boards_spec.ods, EveryCook_boards_spec_V2.ods]
2014-01-12 Logic board all routed...
    [EveryCook_RaspiShield_V3.brd, EveryCook_RaspiShield_V3.sch]
2014-01-12 changed all 0606 to 0805 package for R and C.
    [EveryCook_RaspiShield_V3.brd, EveryCook_RaspiShield_V3.sch]
2014-01-14 Cleaned up the logic board. added safety chain board.
    [EveryCook_RaspiShield_V3.brd, EveryCook_RaspiShield_V3.sch, SafetyChain.brd, SafetyChain.sch, TRIAC-driver.brd]
2014-01-18 Re-routed a display pin to have the whole display on ports B and C. Safety chain board layouted.
    [EveryCookPWR (Alexis Wiasmitinows in Konflikt stehende Kopie 2014-01-17).dxf, EveryCookPWR.dxf, EveryCook_RaspiShield_V3.brd, EveryCook_RaspiShield_V3.sch, SafetyChain.brd, SafetyChain.sch]
2014-01-21 Renamed files.
    [Display_EveryCook.brd, Display_EveryCook.sch, EveryCook_Mainboard.brd, EveryCook_Mainboard.sch, EveryCook_RaspiShield_V3.brd, EveryCook_RaspiShield_V3.sch, SHIELD-LOL-SMT_EveryCook.brd, SHIELD-LOL-SMT_EveryCook.dxf]
2014-01-22 Changed USB connectors, created gerber Files
    [Display_EveryCook.brd, Display_EveryCook.xls, EveryCook_Mainboard.brd, EveryCook_Mainboard.sch, EveryCook_Mainboard.xls, SafetyChain.brd, SafetyChain_BOM.csv, SafetyChain_BOM.xls]
2014-02-05 Redesign of all boards.
    [Cables_and_Sensors_EveryCook.ods, Display_EveryCook.brd, Display_EveryCook.csv, Display_EveryCook.sch, Display_EveryCook.xls, EveryCook_Mainboard.brd, EveryCook_Mainboard.csv, EveryCook_Mainboard.sch]
2014-02-06 Removed RX/TX traces, added solder pads
    [Display_EveryCook.xls]
2014-04-16 Push before major changes.
    [EveryCookPWR.brd, EveryCook_Mainboard.csv, EveryCook_Mainboard.xls, InductionHeater.sch]
2014-05-04 Redesign of mainboard. New load cell amp board.
    [EveryCook_Mainboard.brd, EveryCook_Mainboard.sch, LoadCellAmp.brd, LoadCellAmp.dxf, LoadCellAmp.sch]
2014-05-26 BOM for the LoadCellAmp
    [LoadCellAmp.brd, LoadCellAmp.csv, LoadCellAmp.dxf]
2014-05-26 Added marker, rearranged silkscreen
    [LoadCellAmp.brd, LoadCellAmp.sch]
2014-05-27 Chenged values of R and C.
    [LoadCellAmp.brd, LoadCellAmp.dxf, LoadCellAmp.sch]
2014-05-28 Updated LoadcellAmp BOM
    [LoadCellAmp.csv]
2014-08-21 Added ADC board
    [ADC_LoadCell_Board.brd, ADC_LoadCell_Board.sch, FrequencyConverter.sch, LoadCellAmp.dxf]
