everycook/EveryCook-PCB-layouts/(notices)

Notices in the files:
parts and their libraries:
raspberry_mirr: This library stands under the CERN Open Hardware Licence.
